ebastler/marbastlib/3dmodels/Diodes_UDFN1212-3_Type-C.step

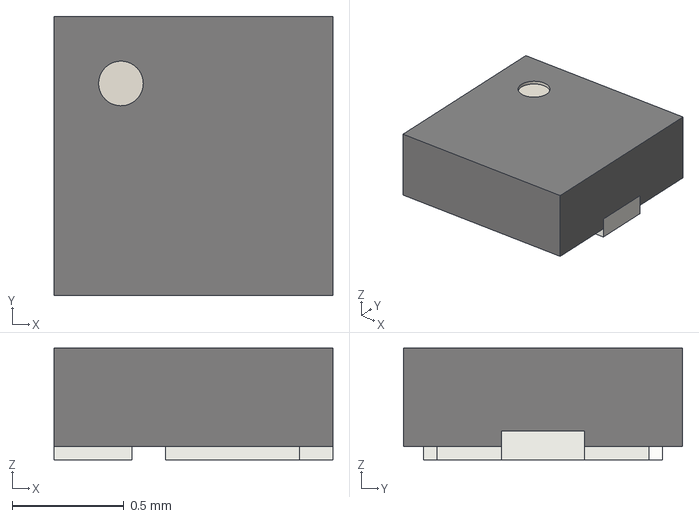
[picture p2: CAD file, 2026-03-22]
3dmodels/Diodes_UDFN1212-3_Type-C.step
1.25 x 1.25 x 0.5 mm
