ebastler/marbastlib/3dmodels/Crystal_SMD_2016-4Pin_2.0x1.6mm.step

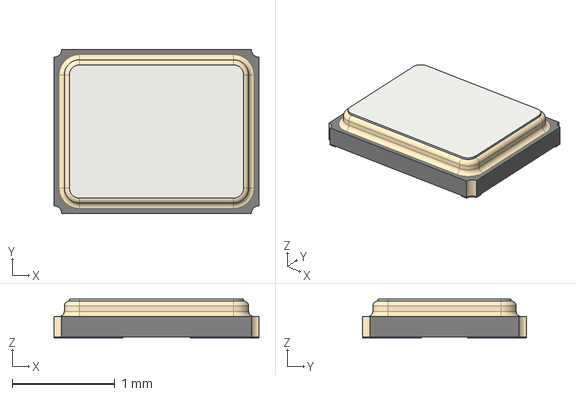
[picture p3: CAD file, 2026-03-22]
3dmodels/Crystal_SMD_2016-4Pin_2.0x1.6mm.step
2.00 x 1.60 x 0.38 mm
