ebastler/marbastlib/3dmodels/SpringContact_SameSky_CPG-45-TH-TR.step

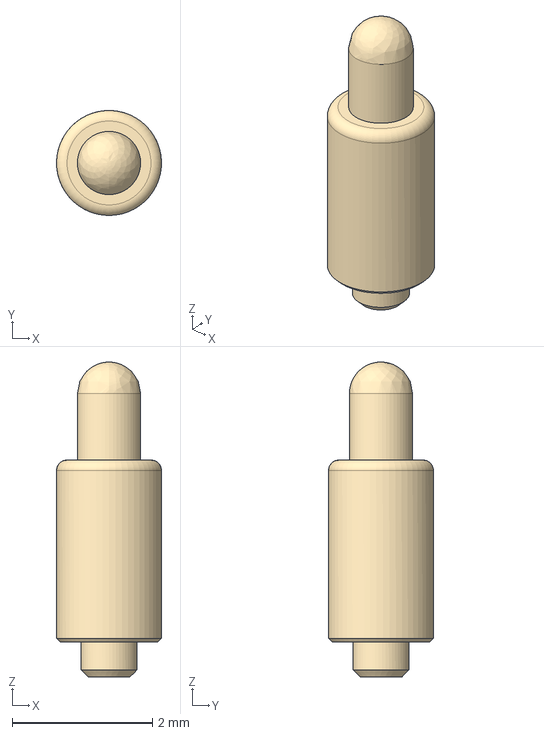
[picture p4: CAD file, 2026-03-22]
3dmodels/SpringContact_SameSky_CPG-45-TH-TR.step
1.50 x 1.50 x 4.50 mm
