ebastler/marbastlib/3dmodels/Mounting_Sinhoo_SolderElement_SMTSO3035CTJ.step

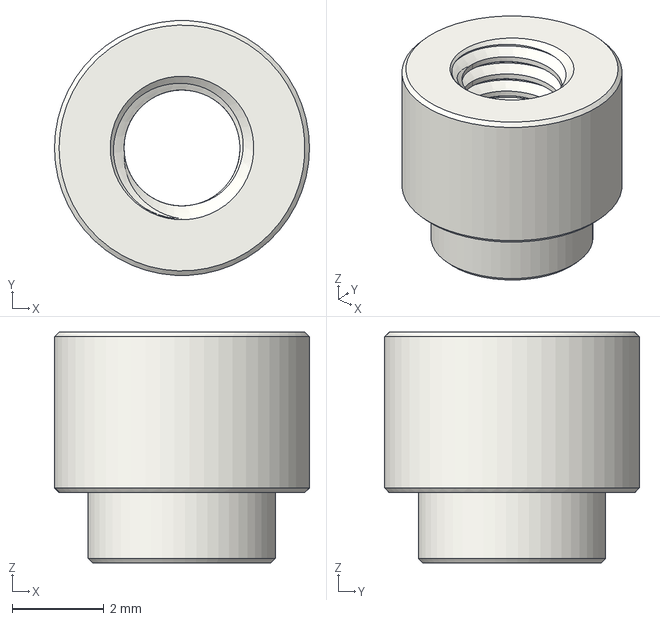
[picture p5: CAD file, 2026-03-22]
3dmodels/Mounting_Sinhoo_SolderElement_SMTSO3035CTJ.step
5.56 x 5.55 x 5.03 mm
