ebastler/marbastlib/3dmodels/LED_Everlight_15-13DR6GHBHC-A012T.step

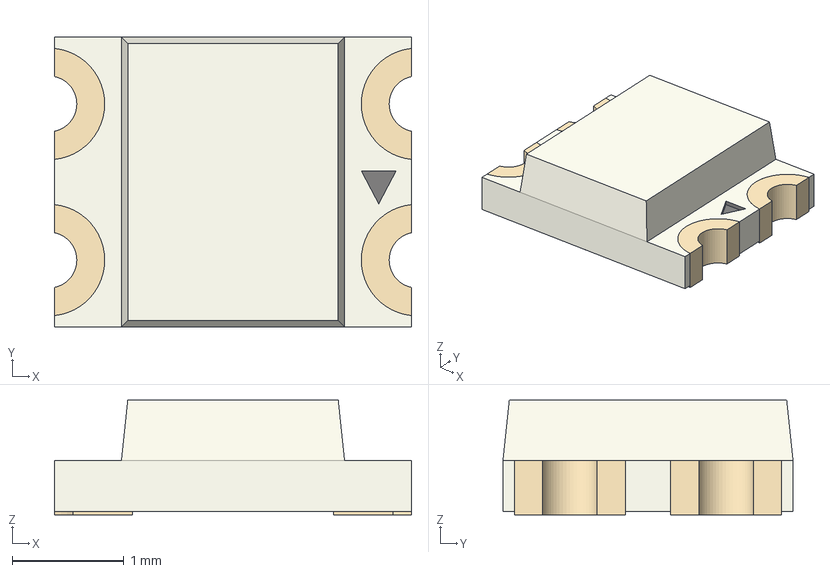
[picture p6: CAD file, 2026-03-22]
3dmodels/LED_Everlight_15-13DR6GHBHC-A012T.step
3.20 x 2.60 x 1.03 mm
