ebastler/marbastlib/3dmodels/SW_Kailh_CPG1316S-2_CAP.step

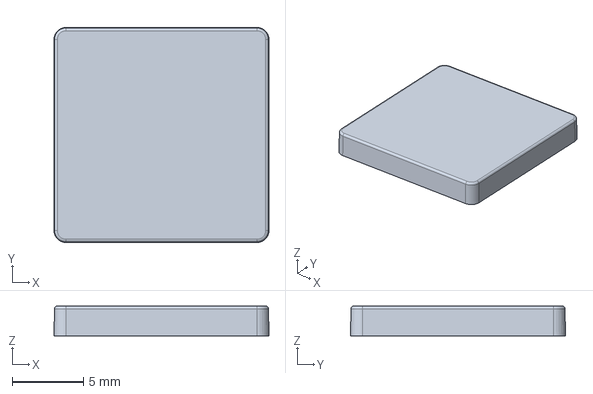
[picture p7: CAD file, 2026-03-22]
3dmodels/SW_Kailh_CPG1316S-2_CAP.step
15.1 x 15.1 x 2.10 mm
