ebastler/marbastlib/3dmodels/Speaker_SELTECH_CR1511L025YN8WP.step

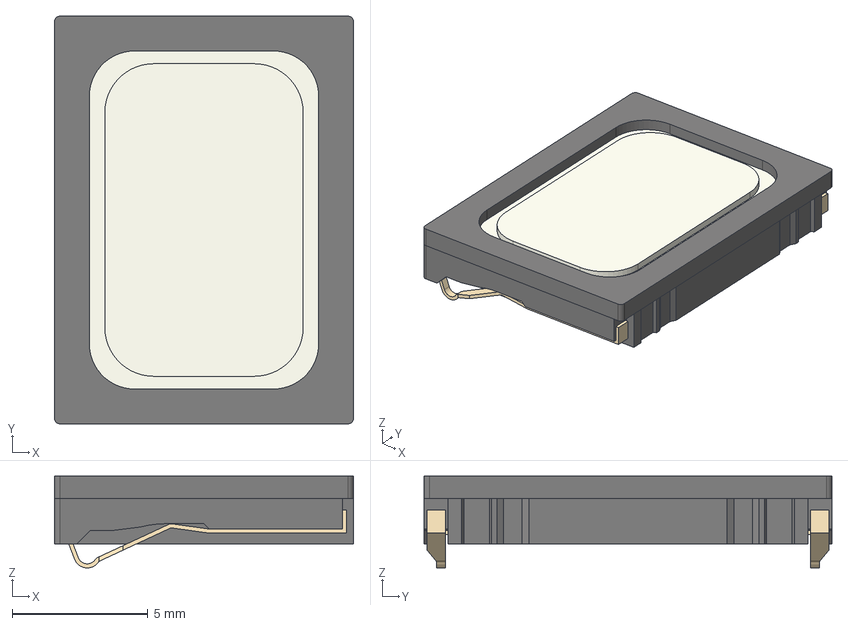
[picture p8: CAD file, 2026-03-22]
3dmodels/Speaker_SELTECH_CR1511L025YN8WP.step
11.0 x 15.0 x 3.38 mm
