ebastler/marbastlib/3dmodels/SW_Kailh_ULP_CPG1316M_CAP.step

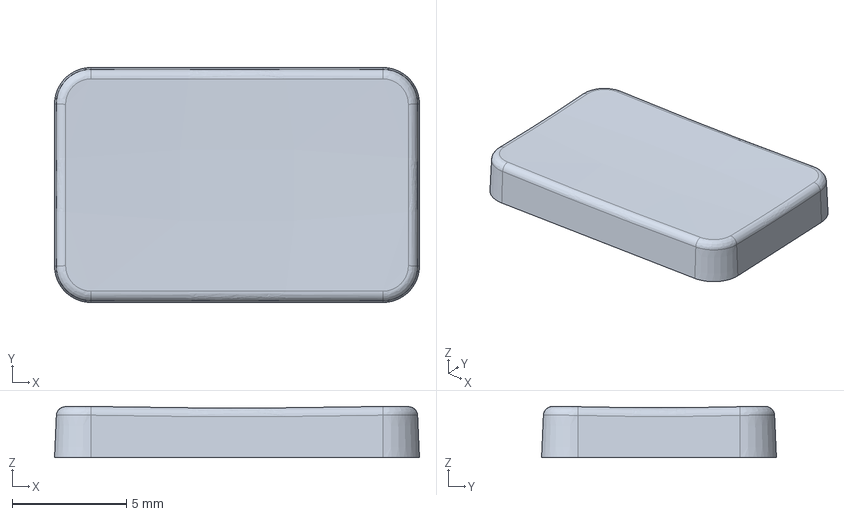
[picture p9: CAD file, 2026-03-22]
3dmodels/SW_Kailh_ULP_CPG1316M_CAP.step
16.0 x 10.3 x 2.25 mm
