ebastler/marbastlib/3dmodels/QFN-14_2x2_Pitch0.4mm.step

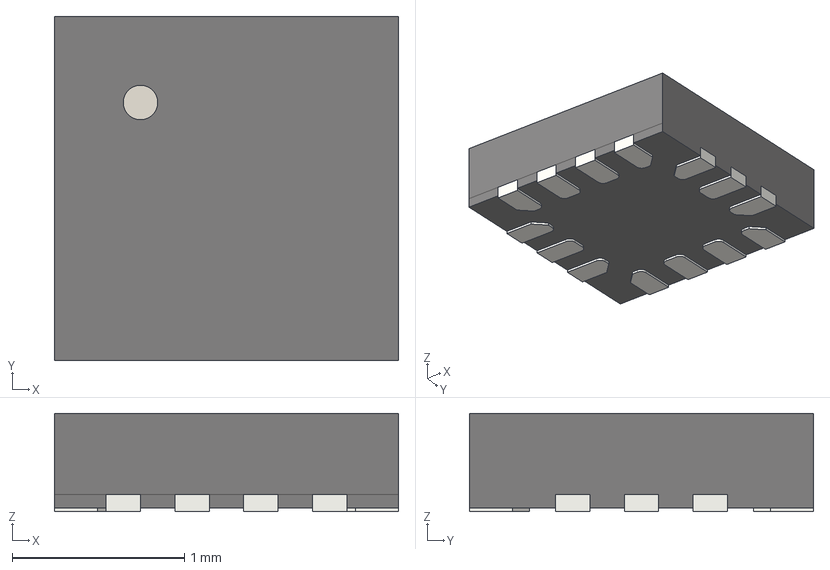
[picture p10: CAD file, 2026-03-22]
3dmodels/QFN-14_2x2_Pitch0.4mm.step
2.00 x 2.00 x 0.57 mm
