ebastler/marbastlib/3dmodels/Texas_OPT3004DNPR_QFN-6_EP_2x2_Pitch0.65mm.step

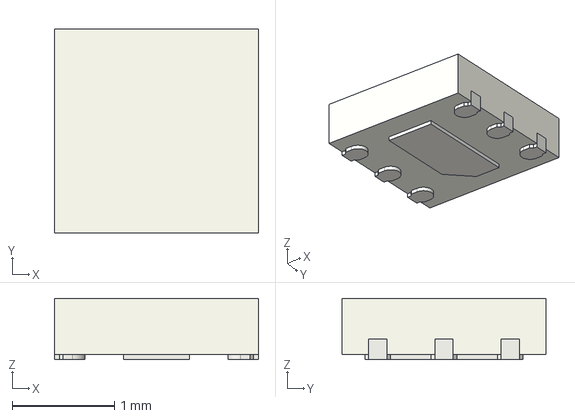
[picture p11: CAD file, 2026-03-22]
3dmodels/Texas_OPT3004DNPR_QFN-6_EP_2x2_Pitch0.65mm.step
2.00 x 2.00 x 0.6 mm
