ebastler/marbastlib/3dmodels/NANOT240BP.step

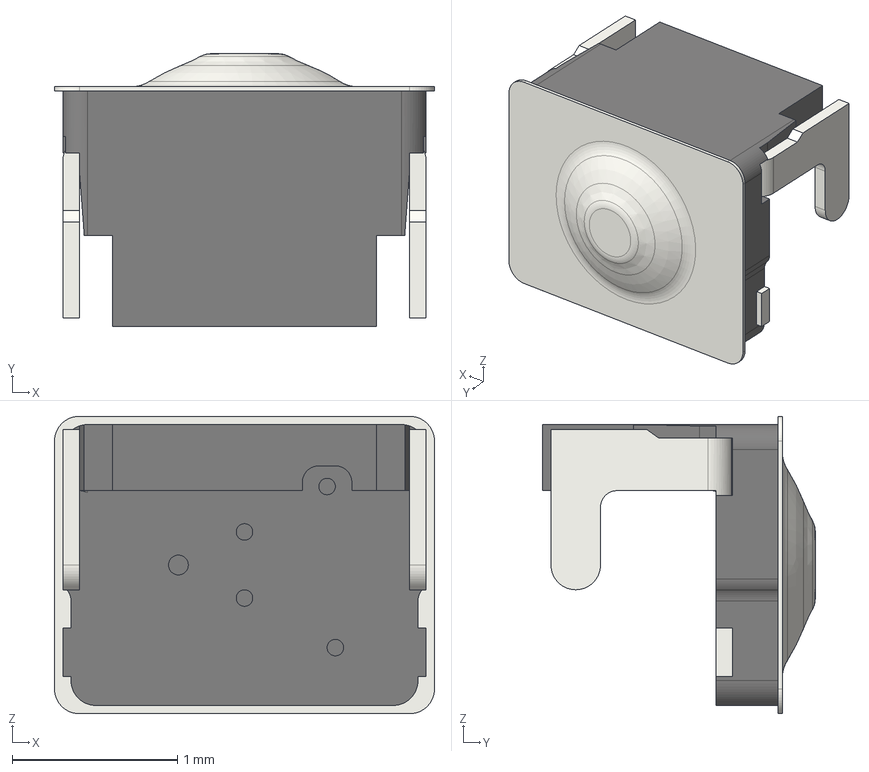
[picture p12: CAD file, 2026-03-22]
3dmodels/NANOT240BP.step
2.30 x 1.65 x 1.80 mm
