ebastler/marbastlib/3dmodels/ANT_Johanson_2450AT18D0100001E v1.step

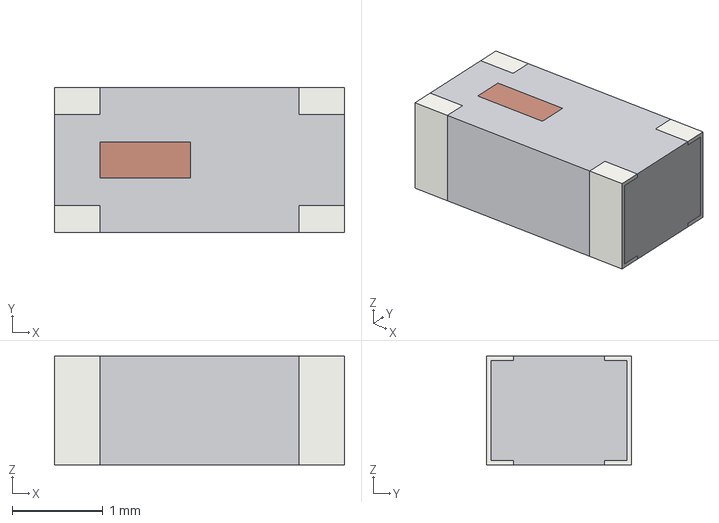
[picture p13: CAD file, 2026-03-22]
3dmodels/ANT_Johanson_2450AT18D0100001E v1.step
3.20 x 1.60 x 1.20 mm
