ebastler/marbastlib/3dmodels/SW_Kailh_CPG1316S-2.step

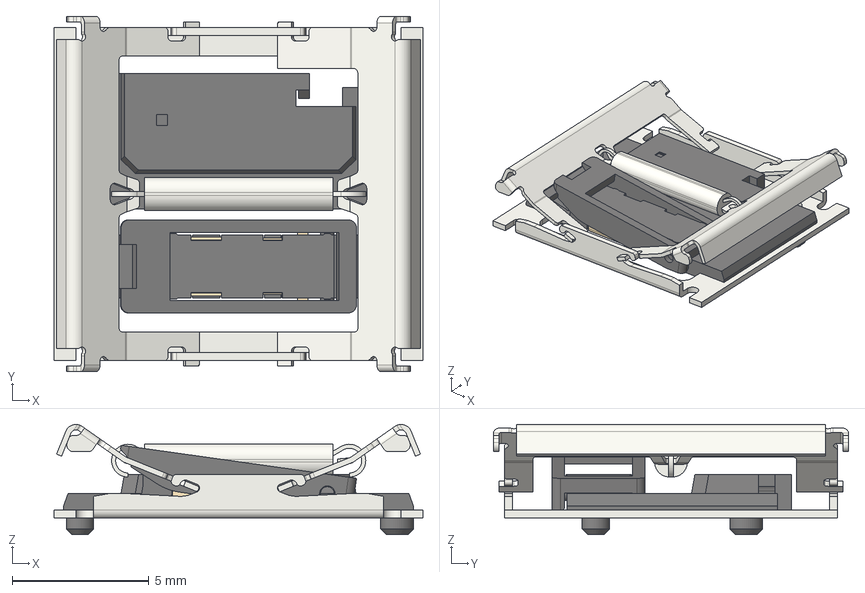
[picture p14: CAD file, 2026-03-22]
3dmodels/SW_Kailh_CPG1316S-2.step
13.5 x 13.0 x 4.03 mm
PG1316S-»ù×ù
Çý¶¯¸Ë
Æ½ºâ¼Ü
À»É
PG1316S-¶¯½Ó´¥Æ¬-´ ø´¥µã
PG1316S-¾²Æ¬-´ø´¥µ ã
Æ½ºâ¼Ü-B
1316S-»ù×ù¿¨¼þ
