ebastler/marbastlib/3dmodels/SpringContact_TE_2329497-2.step

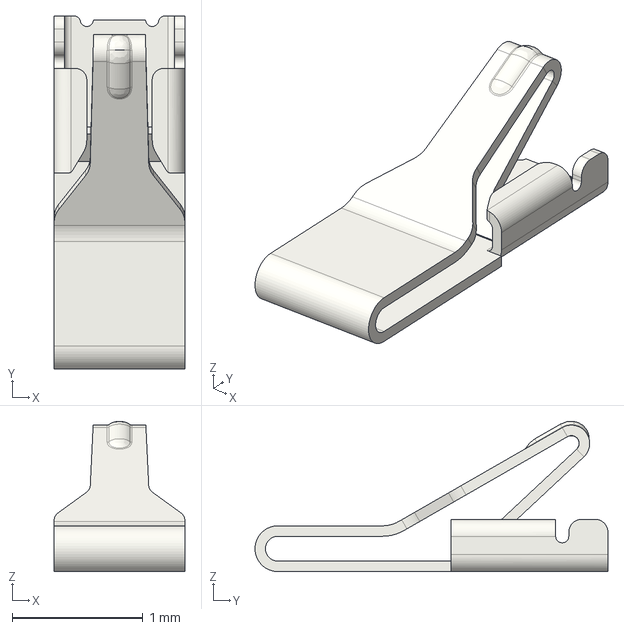
[picture p15: CAD file, 2026-03-22]
3dmodels/SpringContact_TE_2329497-2.step
1.00 x 2.70 x 1.15 mm
