ebastler/marbastlib/3dmodels/Mounting_Wuerth_WA-SMSI-M2_H3P5mm_9774035243R.step

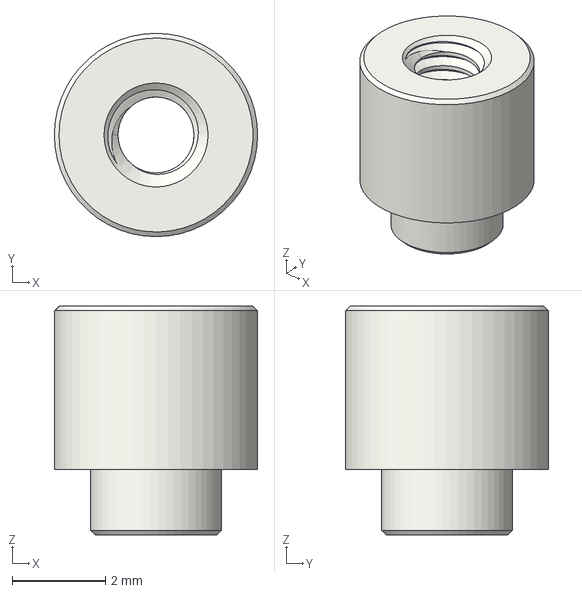
[picture p16: CAD file, 2026-03-22]
3dmodels/Mounting_Wuerth_WA-SMSI-M2_H3P5mm_9774035243R.step
4.35 x 4.35 x 4.90 mm
