ebastler/marbastlib/3dmodels/Crystal_SMD_2012-2Pin_2.0x1.2mm.step

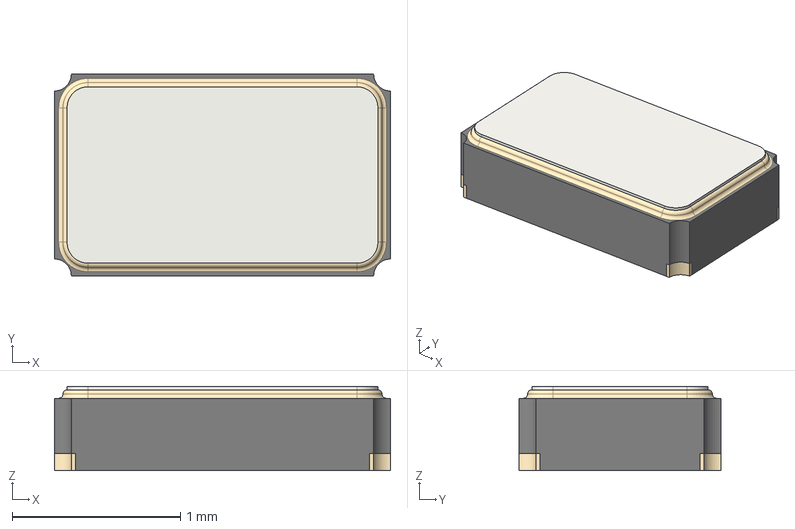
[picture p17: CAD file, 2026-03-22]
3dmodels/Crystal_SMD_2012-2Pin_2.0x1.2mm.step
2.00 x 1.20 x 0.5 mm
