ebastler/marbastlib/3dmodels/Texas_DSBGA-9_1.62x1.58mm_Layout3x3_P0.5mm.step

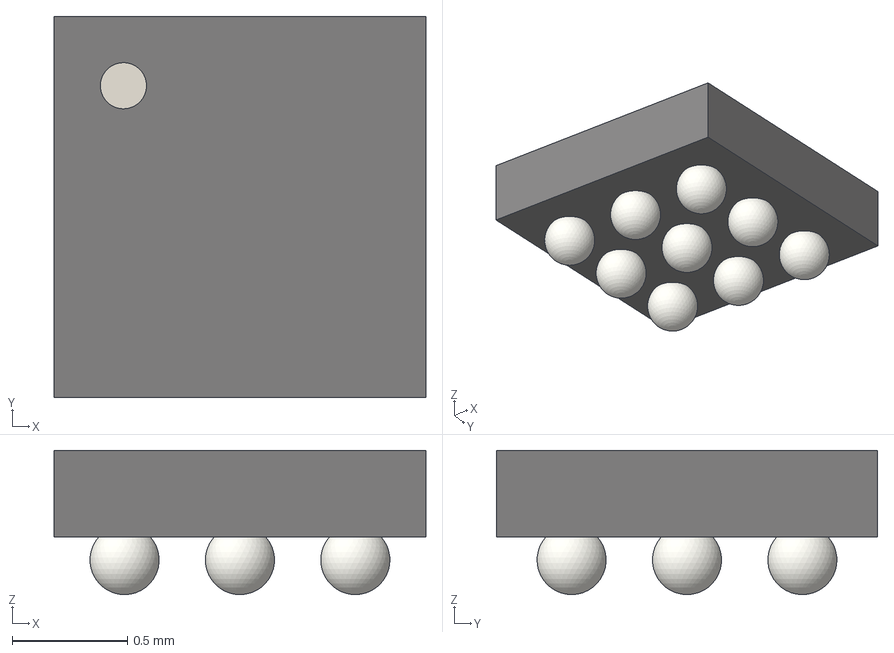
[picture p18: CAD file, 2026-03-22]
3dmodels/Texas_DSBGA-9_1.62x1.58mm_Layout3x3_P0.5mm.step
1.61 x 1.65 x 0.625 mm
