ebastler/marbastlib/3dmodels/Texas_RYK0018A_WQFN-HR-18.step

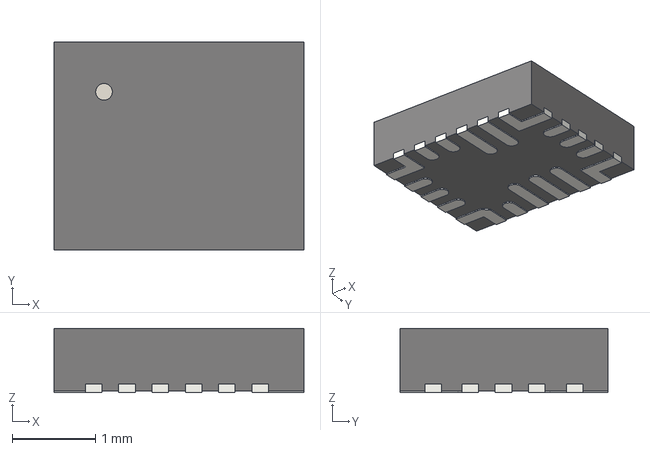
[picture p19: CAD file, 2026-03-22]
3dmodels/Texas_RYK0018A_WQFN-HR-18.step
3.00 x 2.50 x 0.77 mm
