ebastler/marbastlib/3dmodels/USB_C_Receptacle_GCT_USB4505-03-0-A.step

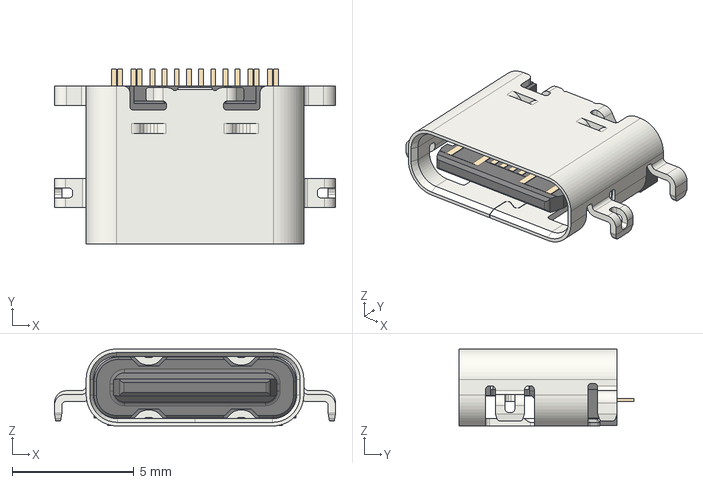
[picture p21: CAD file, 2026-03-22]
3dmodels/USB_C_Receptacle_GCT_USB4505-03-0-A.step
11.5 x 7.20 x 3.16 mm
USB4505-03-0-A_PART1
USB4505-03-0-A_PART2
