ebastler/marbastlib/3dmodels/SW_SPDT_Alps_SSAJ110100.step

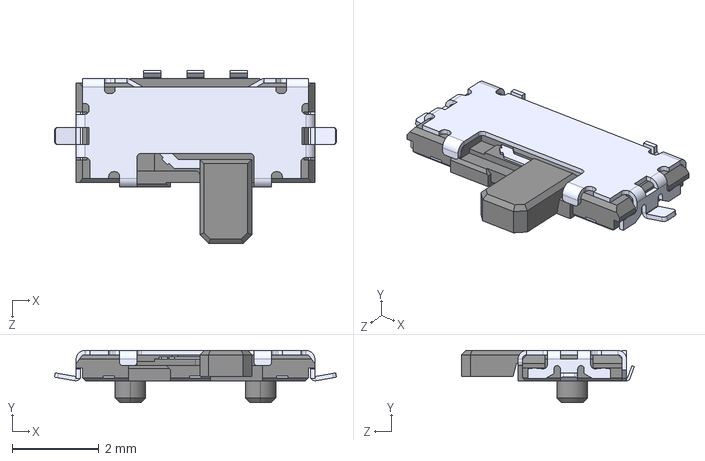
[picture p22: CAD file, 2026-03-22]
3dmodels/SW_SPDT_Alps_SSAJ110100.step
6.50 x 1.20 x 3.98 mm
