ebastler/marbastlib/3dmodels/Texas_X2QFN-12_1.6x1.6mm.step

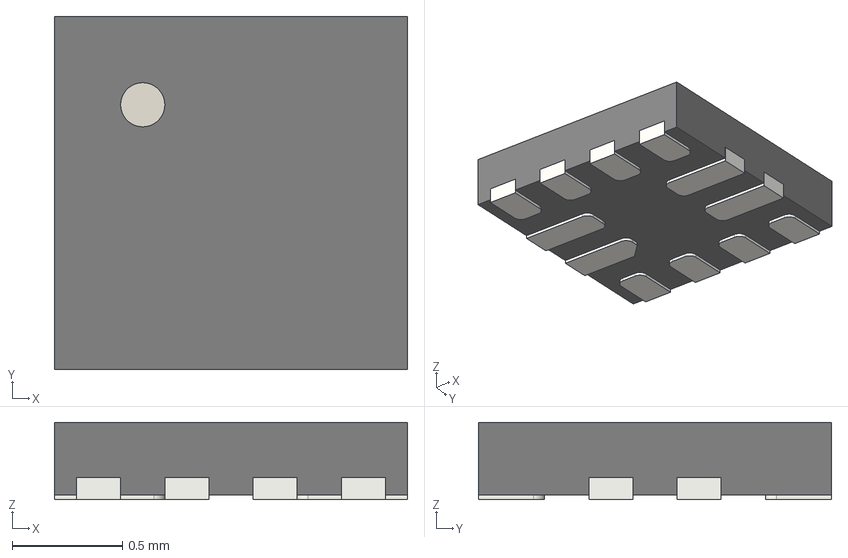
[picture p23: CAD file, 2026-03-22]
3dmodels/Texas_X2QFN-12_1.6x1.6mm.step
1.60 x 1.60 x 0.35 mm
