ebastler/marbastlib/3dmodels/USB_C_Receptacle_GCT_USB4510-03-1-A.step

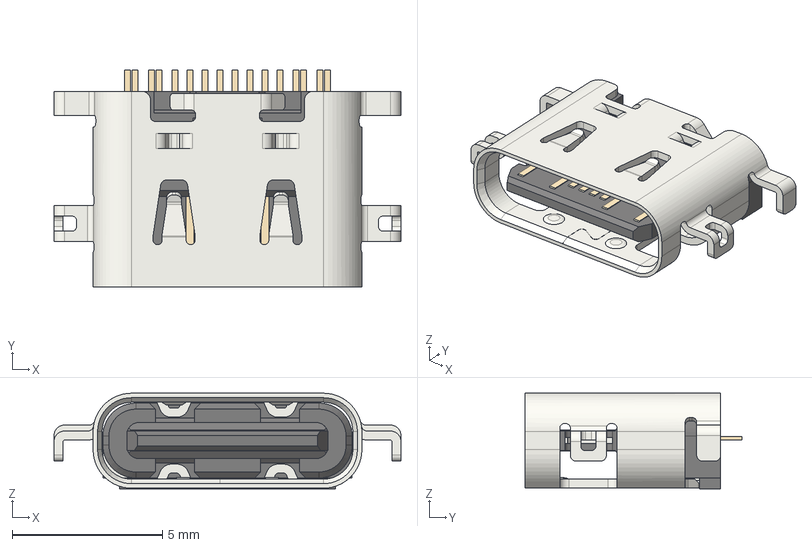
[picture p24: CAD file, 2026-03-22]
3dmodels/USB_C_Receptacle_GCT_USB4510-03-1-A.step
11.5 x 7.20 x 3.18 mm
