ebastler/marbastlib/3dmodels/Mounting_Wuerth_WA-SMSI-M2.5_H1mm_9774010151R.step

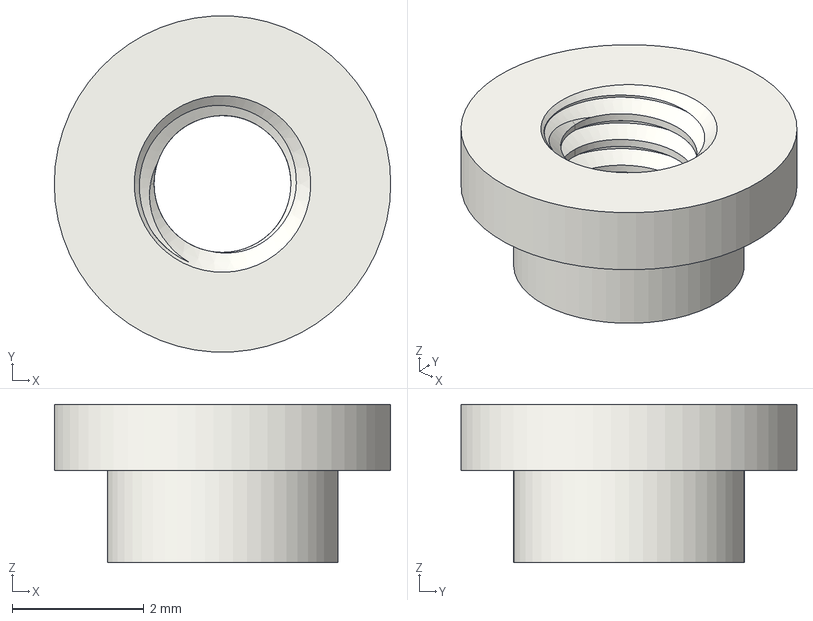
[picture p25: CAD file, 2026-03-22]
3dmodels/Mounting_Wuerth_WA-SMSI-M2.5_H1mm_9774010151R.step
5.10 x 5.09 x 2.40 mm
