ebastler/marbastlib/3dmodels/RP2040-Matrix.step

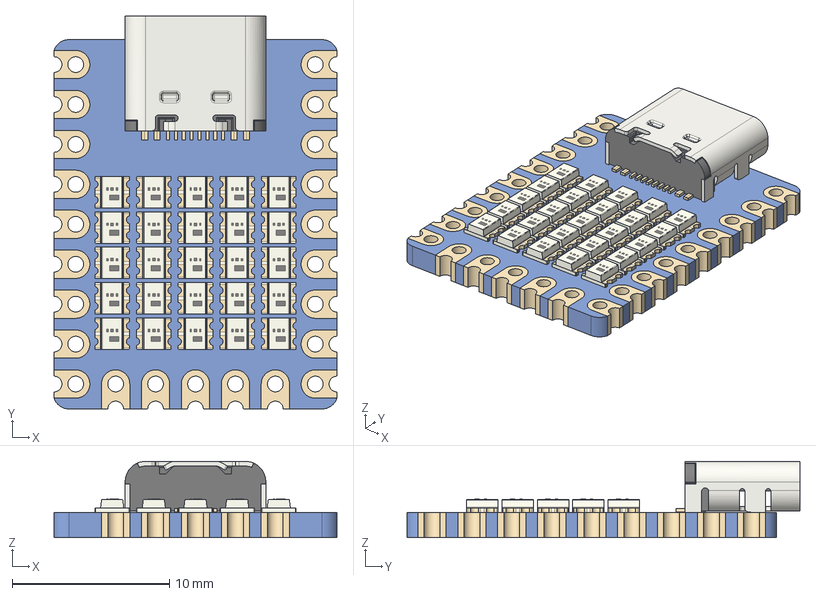
[picture p26: CAD file, 2024-08-18]
3dmodels/RP2040-Matrix.step
18.0 x 25.0 x 4.85 mm
LED_WS2812_2020 x 25
ConPins
PcbPins
Mold
Frame
