ebastler/marbastlib/3dmodels/CON_2121340004.step

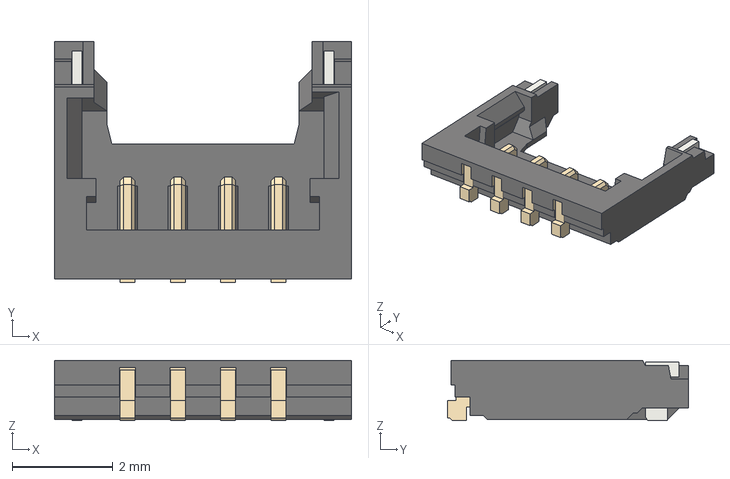
[picture p27: CAD file, 2024-07-13]
3dmodels/CON_2121340004.step
5.90 x 4.79 x 1.20 mm
