ebastler/marbastlib/3dmodels/CON_TYPE-C-31-M-23.step

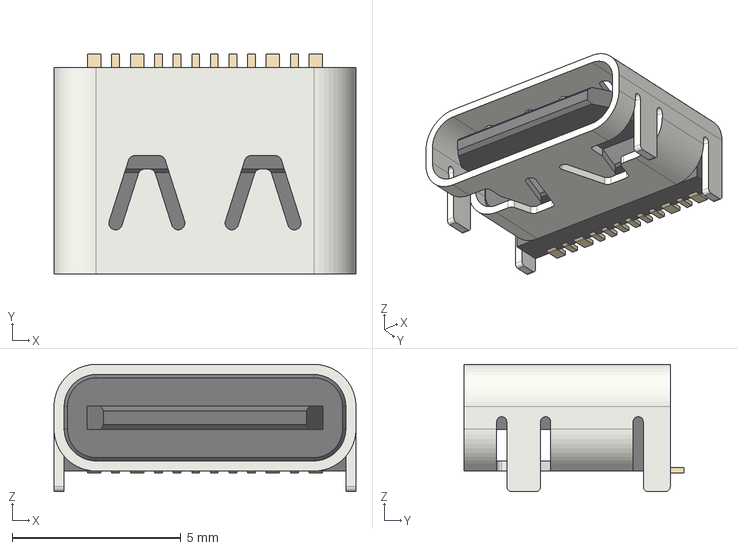
[picture p28: CAD file, 2024-07-13]
3dmodels/CON_TYPE-C-31-M-23.step
8.94 x 6.50 x 3.77 mm
