ebastler/marbastlib/3dmodels/LED_SK6812MINI-E.step

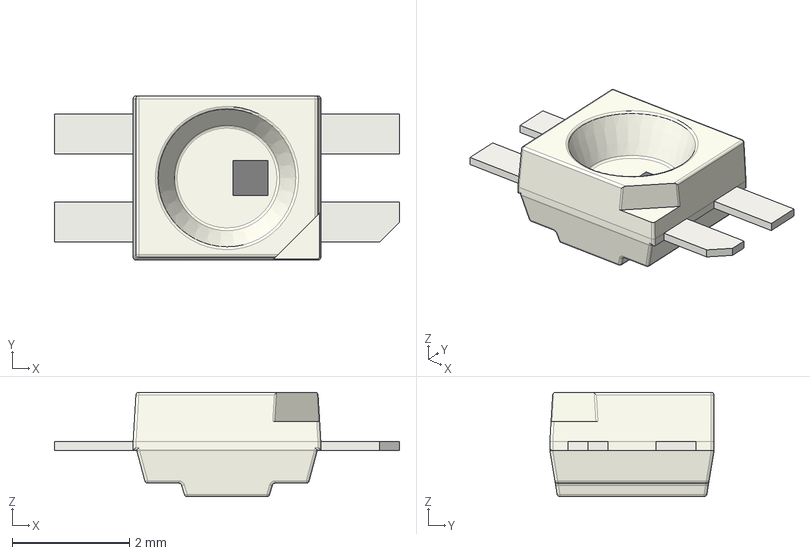
[picture p29: CAD file, 2024-07-13]
3dmodels/LED_SK6812MINI-E.step
5.88 x 2.80 x 1.78 mm
