ebastler/marbastlib/3dmodels/CON_XUNPU_FPC-0.5AL-20PB.step

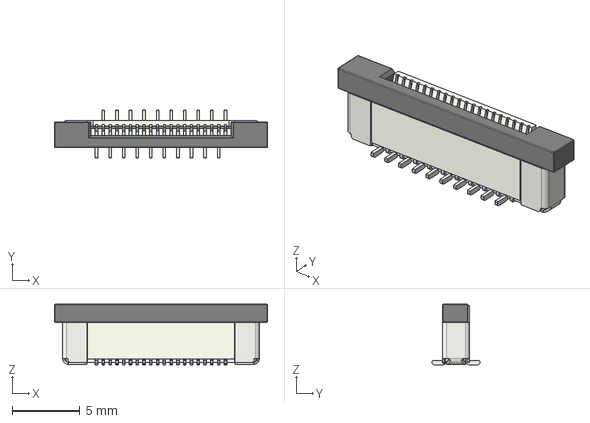
[picture p30: CAD file, 2024-07-13]
3dmodels/CON_XUNPU_FPC-0.5AL-20PB.step
15.7 x 3.52 x 4.47 mm
