ebastler/marbastlib/3dmodels/moko_mk08a_nRF52840.step

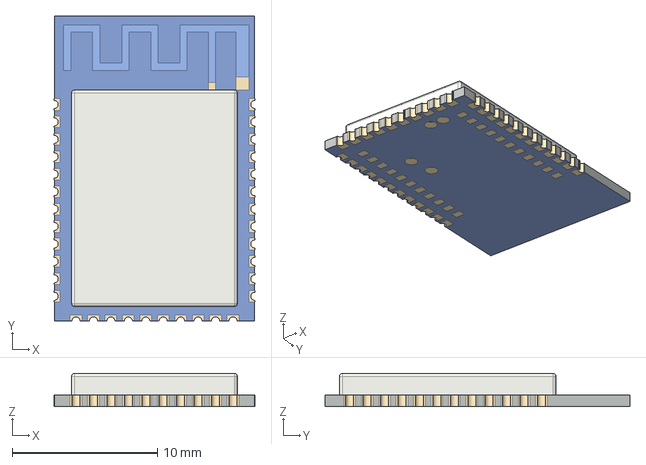
[picture p31: CAD file, 2024-07-13]
3dmodels/moko_mk08a_nRF52840.step
13.8 x 21.0 x 2.29 mm
