ebastler/marbastlib/3dmodels/HS_CPG151101S11_MX.step

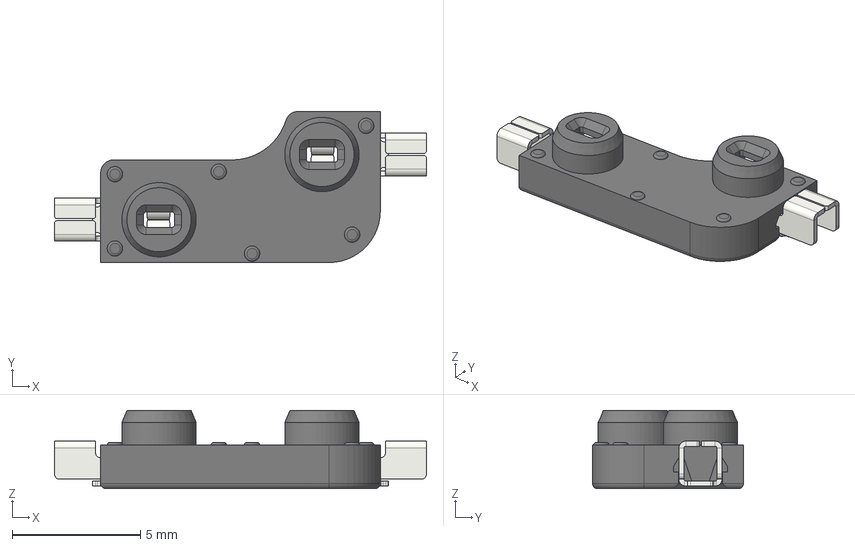
[picture p32: CAD file, 2024-07-13]
3dmodels/HS_CPG151101S11_MX.step
14.5 x 5.89 x 3.05 mm
Contact x 2
