ebastler/marbastlib/3dmodels/CON_SM05B-SRSS-TB.step

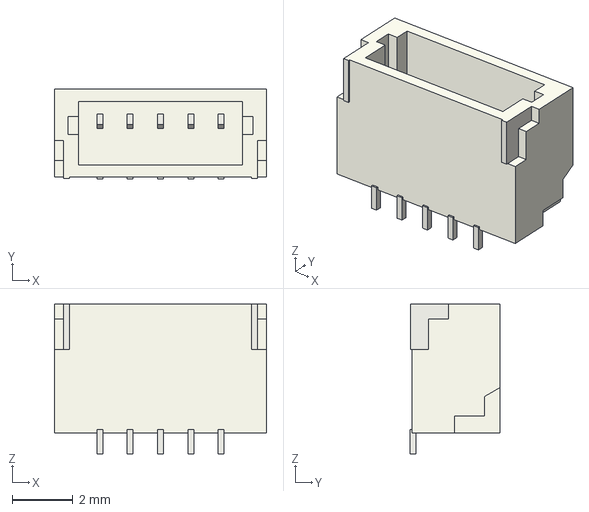
[picture p33: CAD file, 2024-07-13]
3dmodels/CON_SM05B-SRSS-TB.step
7.00 x 2.96 x 4.95 mm
