ebastler/marbastlib/3dmodels/PDFN3.3x3.3.step

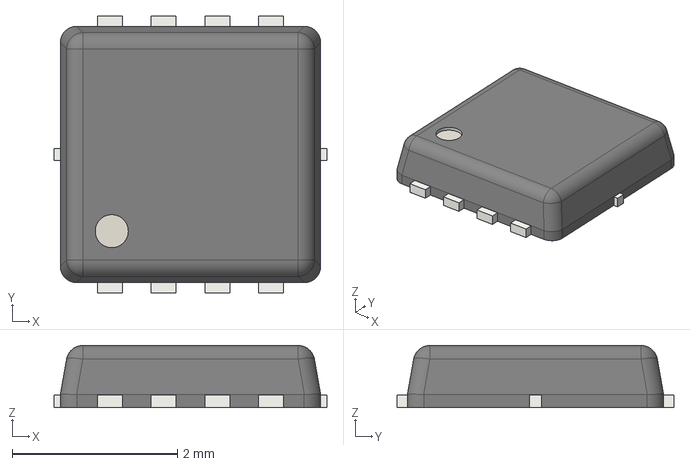
[picture p34: CAD file, 2024-07-13]
3dmodels/PDFN3.3x3.3.step
3.30 x 3.35 x 0.75 mm
