ebastler/marbastlib/3dmodels/SW_T1A2QR.step

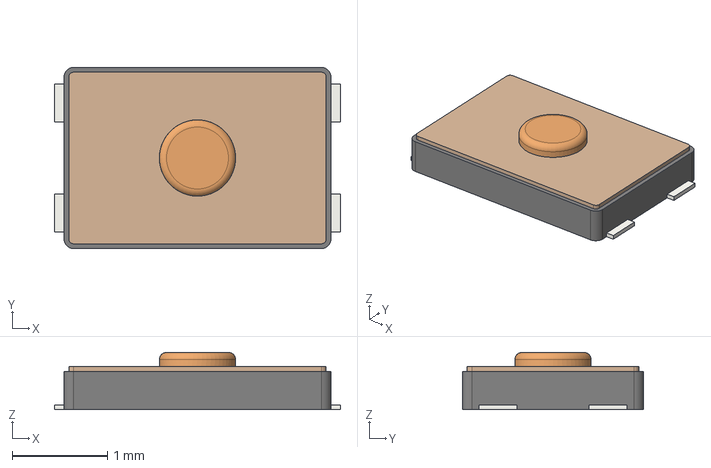
[picture p35: CAD file, 2024-07-13]
3dmodels/SW_T1A2QR.step
3.00 x 1.90 x 0.6 mm
