ebastler/marbastlib/3dmodels/CON_2082940030.step

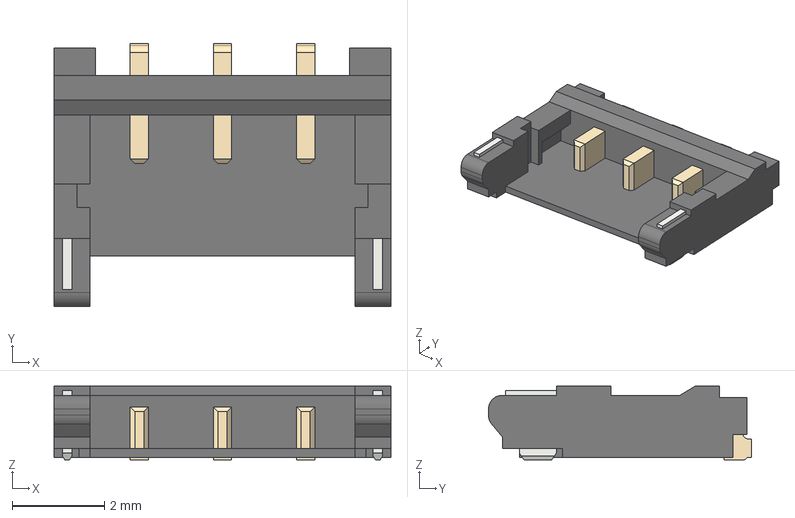
[picture p36: CAD file, 2024-07-13]
3dmodels/CON_2082940030.step
7.30 x 5.70 x 1.60 mm
