ebastler/marbastlib/3dmodels/Liatris.step

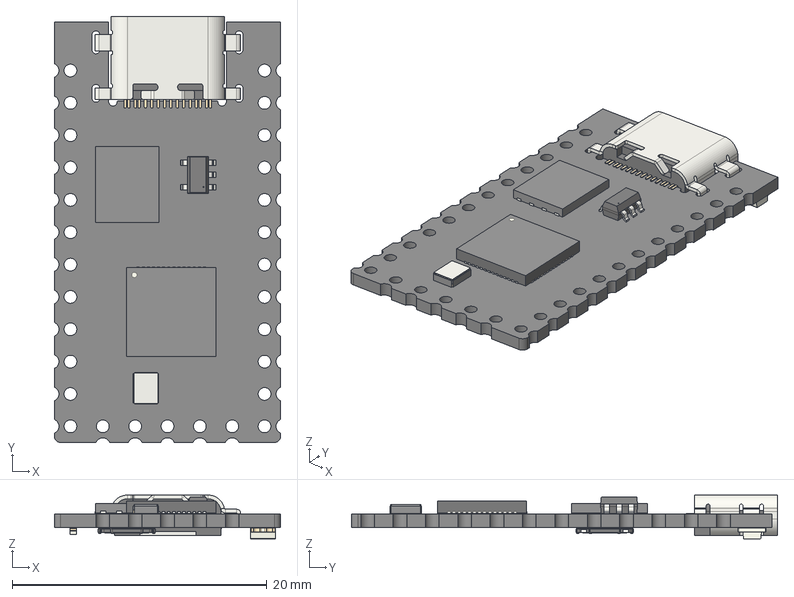
[picture p37: CAD file, 2024-07-13]
3dmodels/Liatris.step
17.8 x 33.5 x 3.44 mm
RP2040 PCB
