ebastler/marbastlib/3dmodels/HS_KS-2P02B01-02_KS33.step

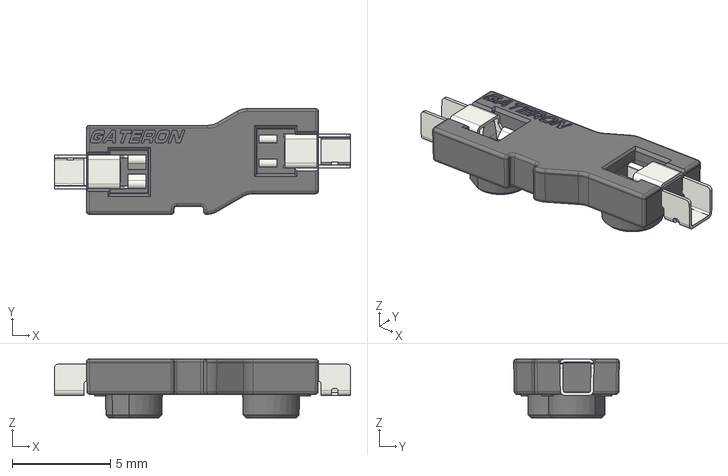
[picture p38: CAD file, 2024-07-13]
3dmodels/HS_KS-2P02B01-02_KS33.step
15.1 x 5.39 x 3.00 mm
