ebastler/marbastlib/3dmodels/SW_MSK12C02.step

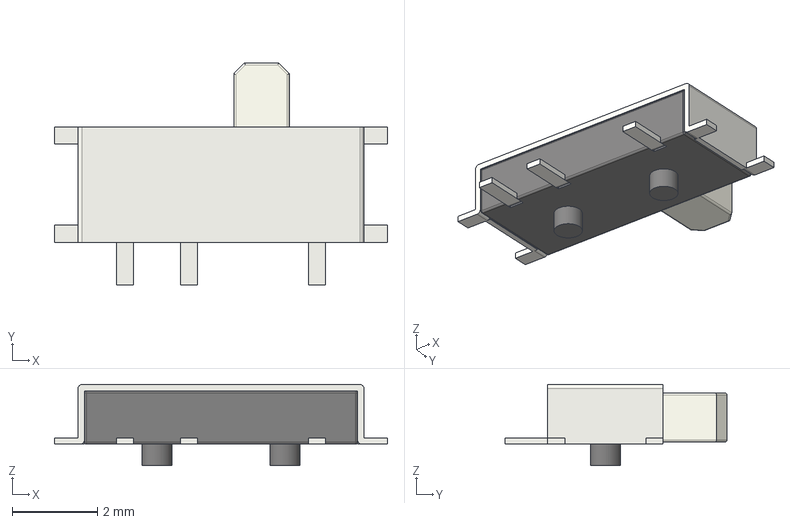
[picture p39: CAD file, 2024-07-13]
3dmodels/SW_MSK12C02.step
7.80 x 5.20 x 1.90 mm
