ebastler/marbastlib/3dmodels/L_Bourns_SRP6050CA.step

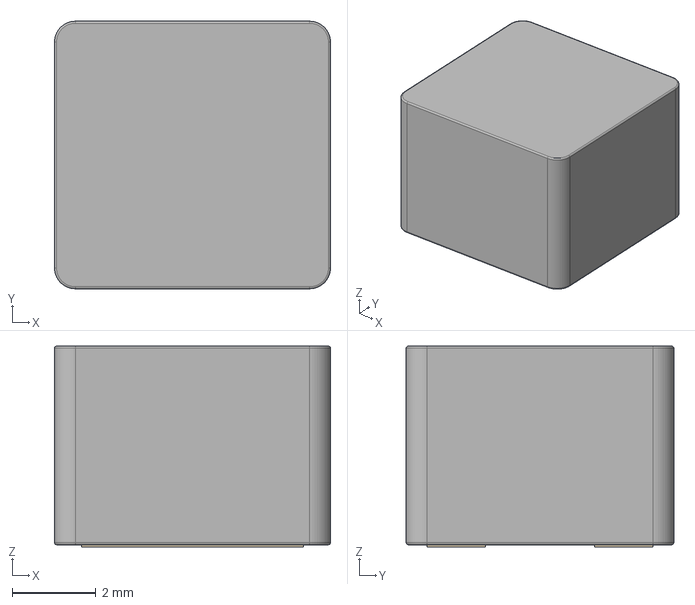
[picture p40: CAD file, 2024-07-13]
3dmodels/L_Bourns_SRP6050CA.step
6.60 x 6.40 x 4.80 mm
