ebastler/marbastlib/3dmodels/L_Cenker_CKST353220.step

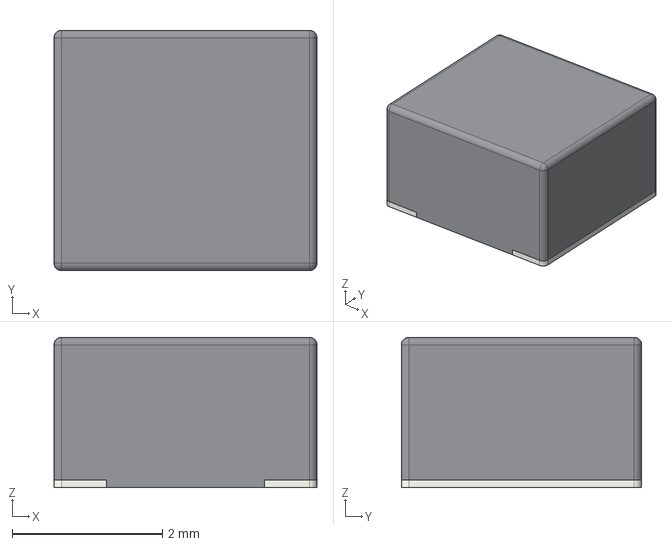
[picture p41: CAD file, 2024-07-13]
3dmodels/L_Cenker_CKST353220.step
3.50 x 3.20 x 2.00 mm
