ebastler/marbastlib/3dmodels/L_Bourns_SRP6060FA.step

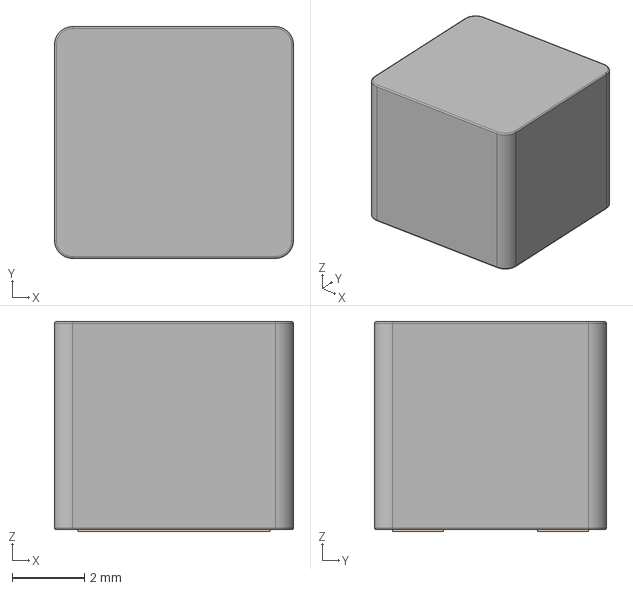
[picture p42: CAD file, 2024-07-13]
3dmodels/L_Bourns_SRP6060FA.step
6.60 x 6.40 x 5.80 mm
