ebastler/marbastlib/3dmodels/CON_MJ-4PP-9.step

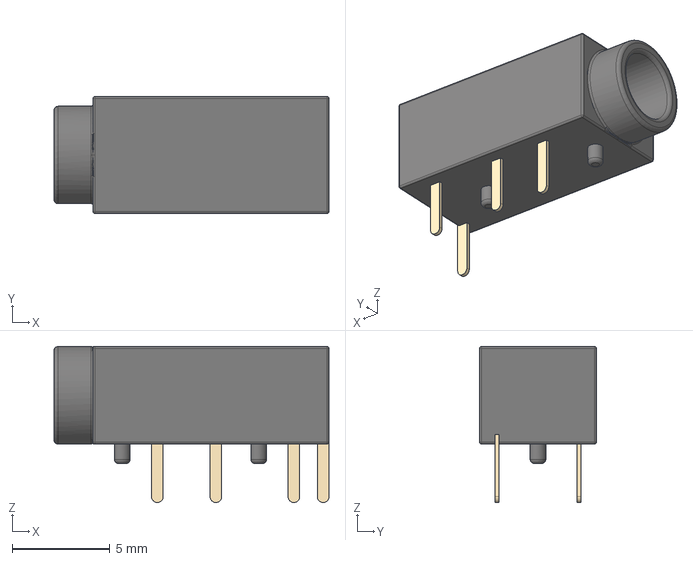
[picture p44: CAD file, 2024-07-13]
3dmodels/CON_MJ-4PP-9.step
14.1 x 6.00 x 8.00 mm
