ebastler/marbastlib/3dmodels/CON_2121340002.step

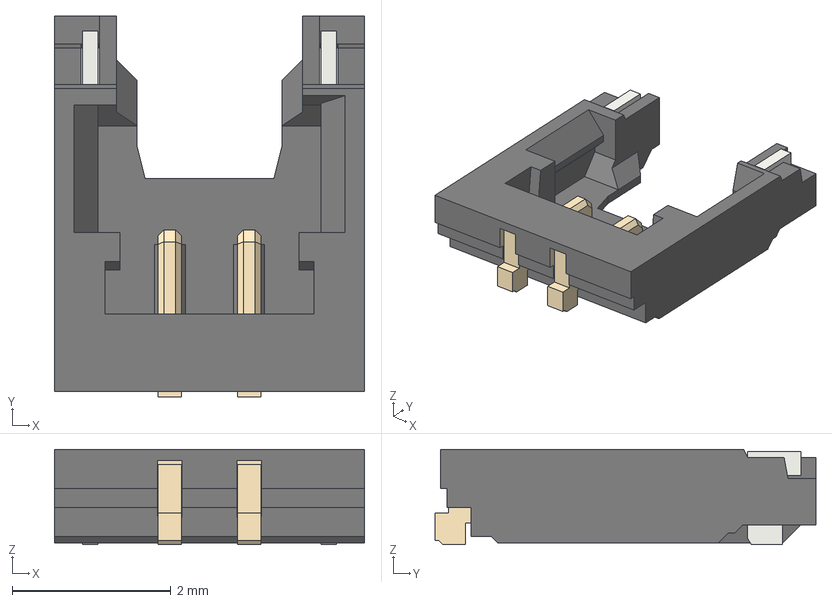
[picture p45: CAD file, 2024-07-13]
3dmodels/CON_2121340002.step
3.90 x 4.79 x 1.20 mm
