ebastler/marbastlib/3dmodels/CON_SM04B-SRSS-TB.step

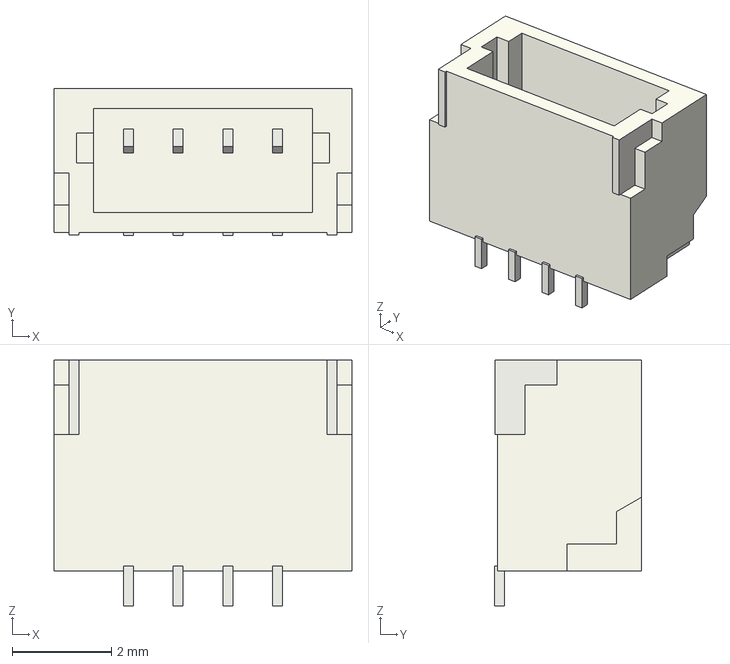
[picture p46: CAD file, 2024-07-13]
3dmodels/CON_SM04B-SRSS-TB.step
6.00 x 2.96 x 4.95 mm
