ebastler/marbastlib/3dmodels/CON_2082940040.step

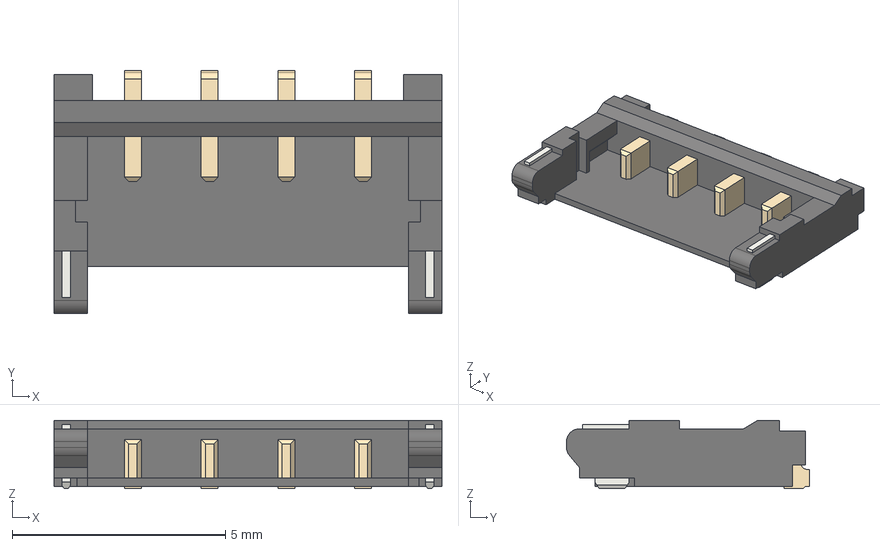
[picture p47: CAD file, 2024-07-13]
3dmodels/CON_2082940040.step
9.10 x 5.70 x 1.60 mm
