ebastler/marbastlib/3dmodels/CON_781715006.step

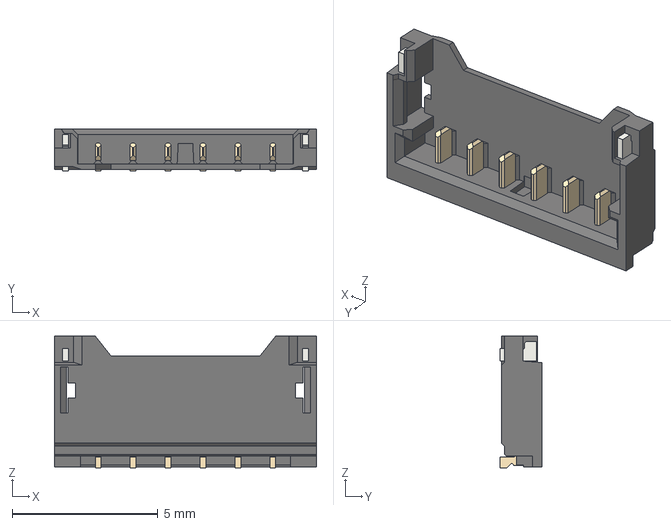
[picture p48: CAD file, 2024-07-13]
3dmodels/CON_781715006.step
9.00 x 1.45 x 4.53 mm
