ebastler/marbastlib/3dmodels/CON_XUNPU_FPC-05F-24PH20.step

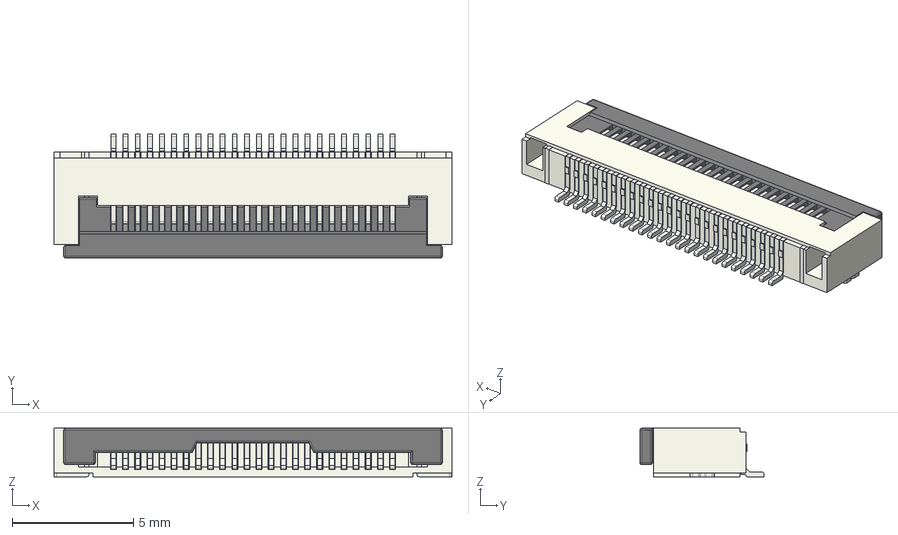
[picture p49: CAD file, 2024-07-13]
3dmodels/CON_XUNPU_FPC-05F-24PH20.step
16.4 x 5.12 x 2.00 mm
Board
