ebastler/marbastlib/3dmodels/LED_WS2812B-MINI.step

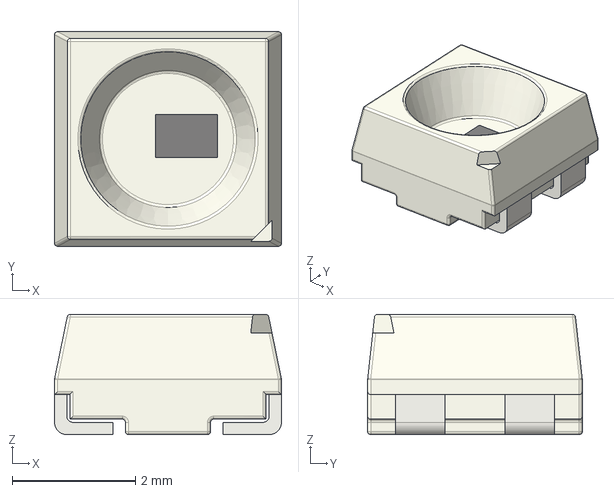
[picture p50: CAD file, 2024-07-13]
3dmodels/LED_WS2812B-MINI.step
3.68 x 3.48 x 1.95 mm
