ebastler/marbastlib/3dmodels/SW_SSSS223900.step

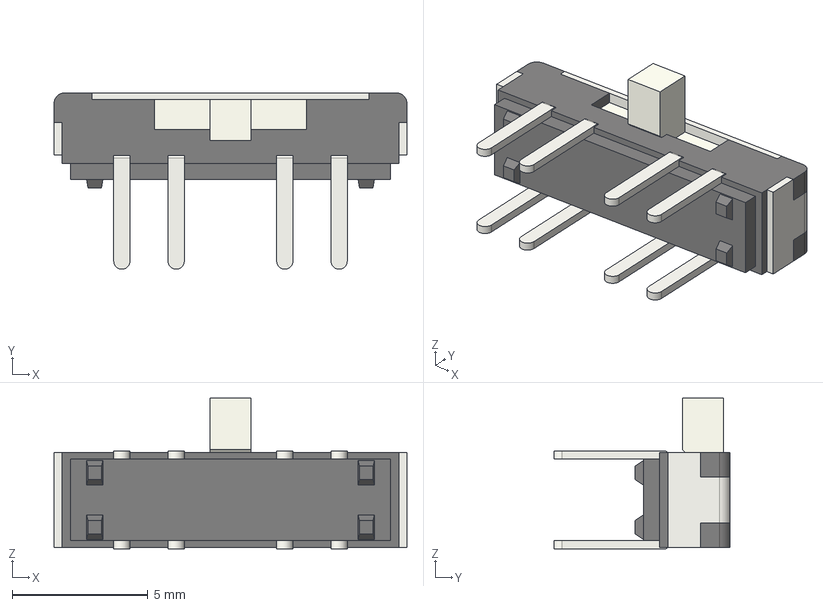
[picture p51: CAD file, 2024-07-13]
3dmodels/SW_SSSS223900.step
13.0 x 6.50 x 5.55 mm
