ebastler/marbastlib/3dmodels/HS_CPG135001S30_Choc.step

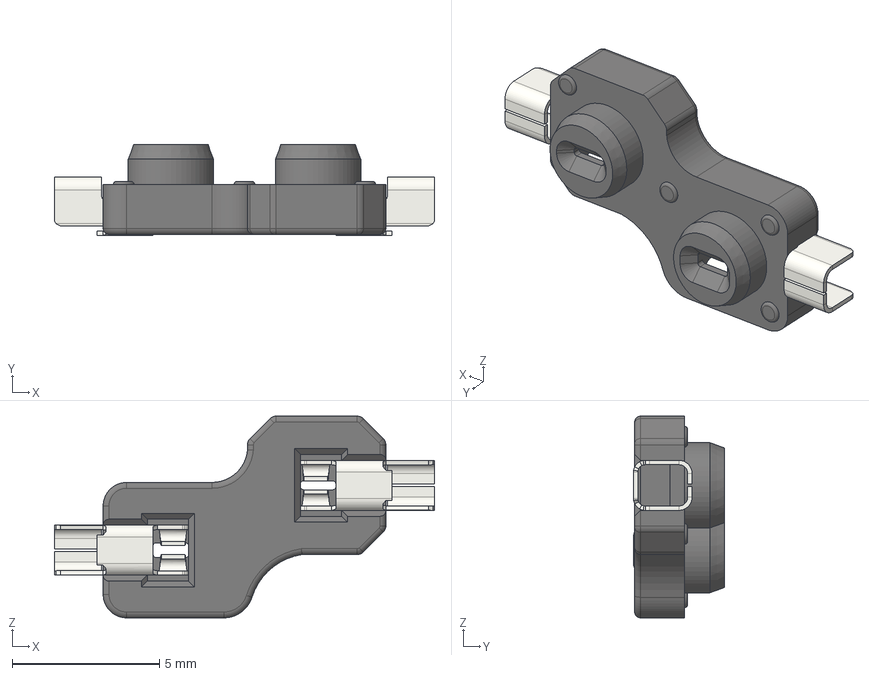
[picture p52: CAD file, 2024-07-13]
3dmodels/HS_CPG135001S30_Choc.step
12.9 x 3.09 x 6.85 mm
pin x 2
socket
