ebastler/marbastlib/3dmodels/CON_2121340006.step

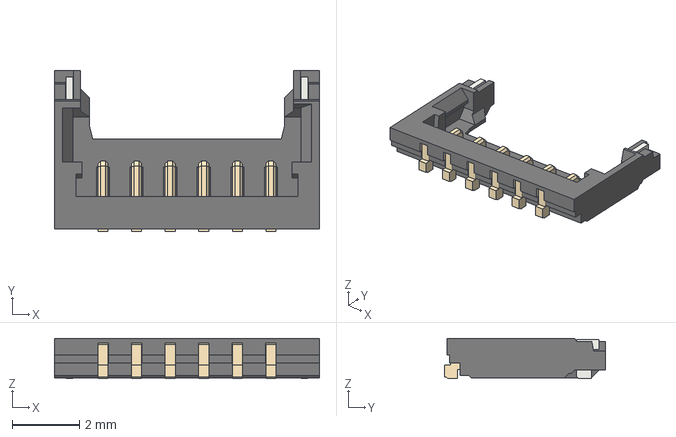
[picture p53: CAD file, 2024-07-13]
3dmodels/CON_2121340006.step
7.90 x 4.79 x 1.20 mm
