ebastler/marbastlib/3dmodels/holyiot_18010_nRF52840.step

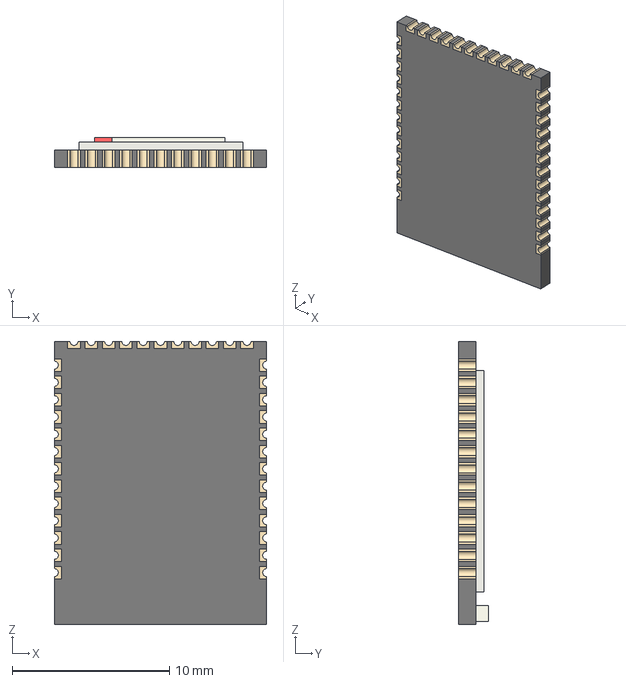
[picture p54: CAD file, 2024-07-13]
3dmodels/holyiot_18010_nRF52840.step
13.5 x 1.92 x 18.0 mm
