ebastler/marbastlib/3dmodels/CON_SM08B-SRSS-TB.step

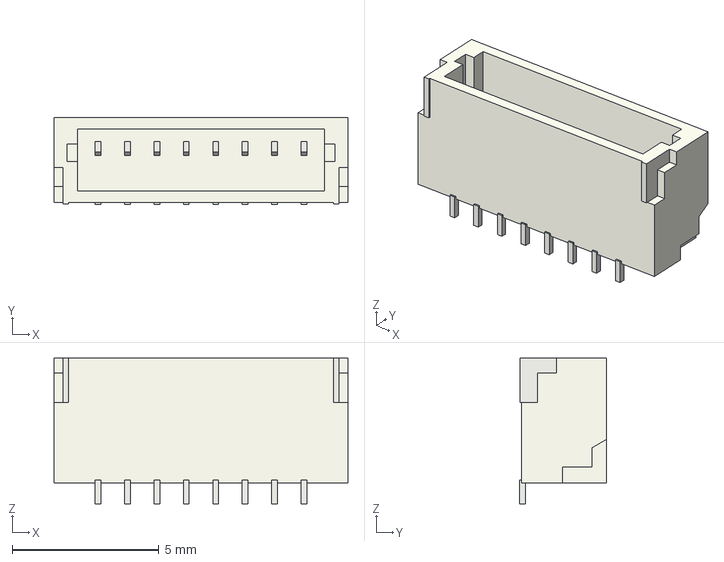
[picture p55: CAD file, 2024-07-13]
3dmodels/CON_SM08B-SRSS-TB.step
10.0 x 2.96 x 4.95 mm
