ebastler/marbastlib/3dmodels/CON_SM13B-SRSS-TB.step

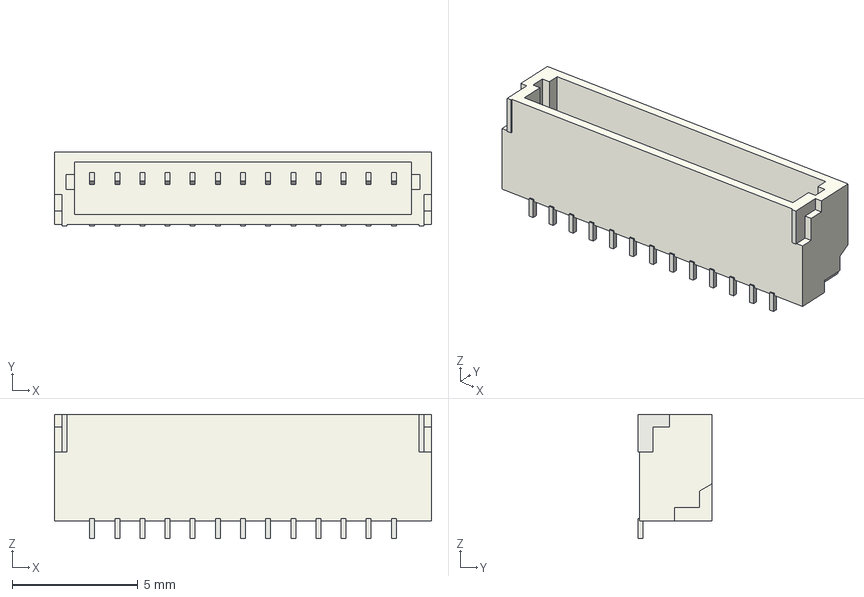
[picture p56: CAD file, 2024-07-13]
3dmodels/CON_SM13B-SRSS-TB.step
15.0 x 2.96 x 4.95 mm
