ebastler/marbastlib/3dmodels/CON_XUNPU_FPC-05F-20PH20.step

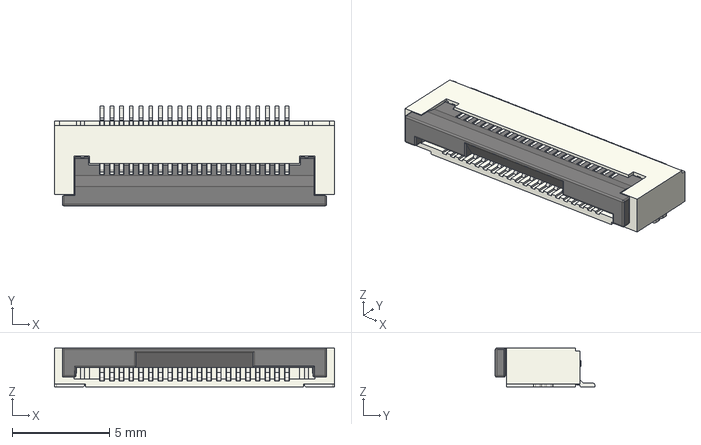
[picture p57: CAD file, 2024-07-13]
3dmodels/CON_XUNPU_FPC-05F-20PH20.step
14.4 x 5.12 x 2.00 mm
Board
