ebastler/marbastlib/3dmodels/CON_BM02B-ACHSS.step

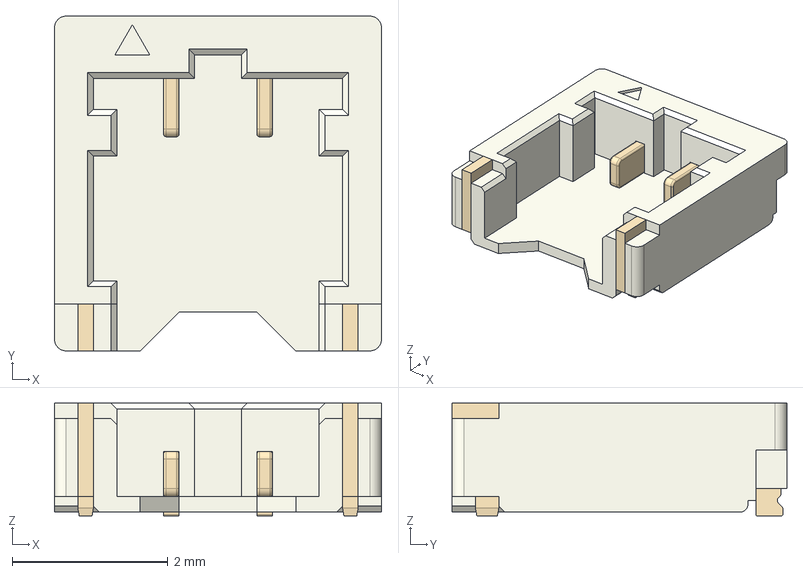
[picture p58: CAD file, 2024-07-13]
3dmodels/CON_BM02B-ACHSS.step
4.20 x 4.30 x 1.45 mm
