ebastler/marbastlib/3dmodels/CON_XUNPU_FPC-05F-16PH20.step

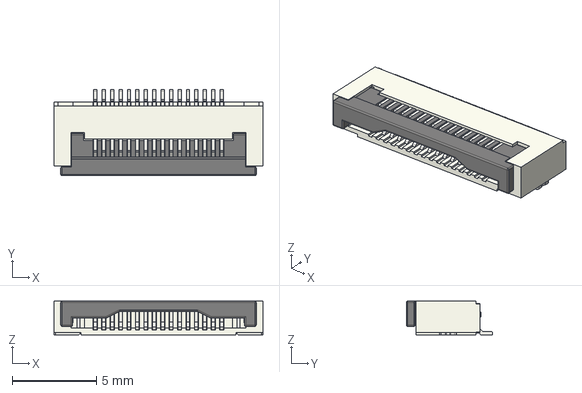
[picture p59: CAD file, 2024-07-13]
3dmodels/CON_XUNPU_FPC-05F-16PH20.step
12.4 x 5.12 x 2.00 mm
