ebastler/marbastlib/3dmodels/ebyte_E73-2G4M08S1C.step

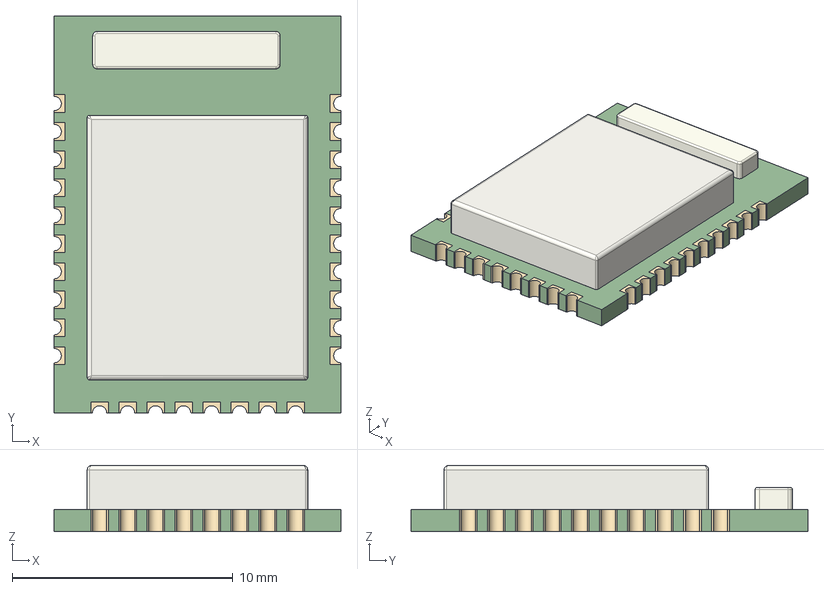
[picture p60: CAD file, 2024-07-13]
3dmodels/ebyte_E73-2G4M08S1C.step
13.0 x 18.0 x 3.00 mm
