ebastler/marbastlib/3dmodels/CON_HytePro_M411P_Receptacle_1x04.step

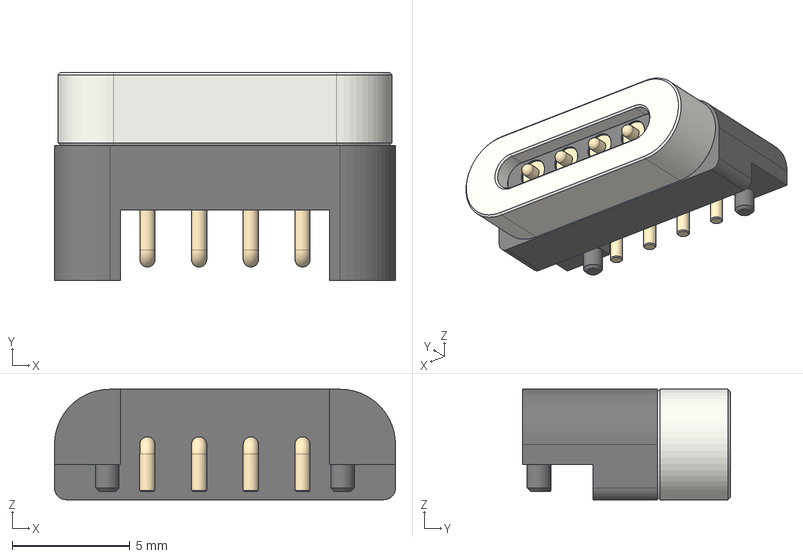
[picture p61: CAD file, 2024-07-13]
3dmodels/CON_HytePro_M411P_Receptacle_1x04.step
14.5 x 8.85 x 4.70 mm
Magnetic Connector Female - MiddlePart
Magnetic Connector Female-tip_Standard
Magnetic Connector Female v2 - MountingPart
