ebastler/marbastlib/3dmodels/LED_WS2812_2020.step

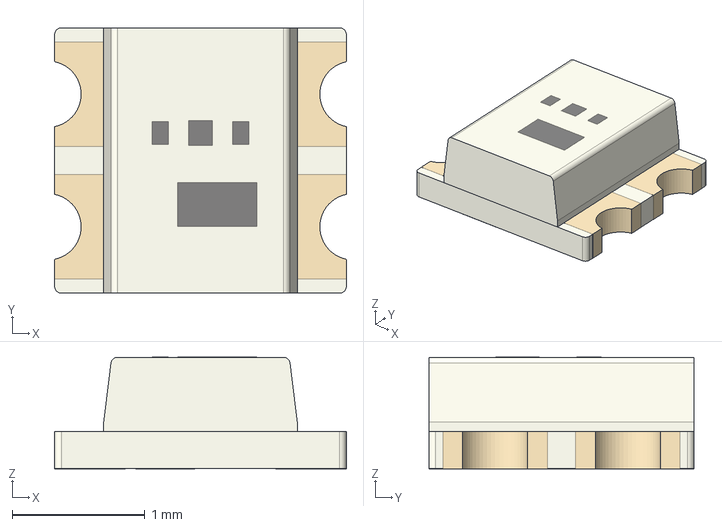
[picture p62: CAD file, 2024-07-13]
3dmodels/LED_WS2812_2020.step
2.20 x 2.00 x 0.842 mm
