ebastler/marbastlib/3dmodels/CON_HC-PBB40C-10DS-0.4V-4.0-02.step

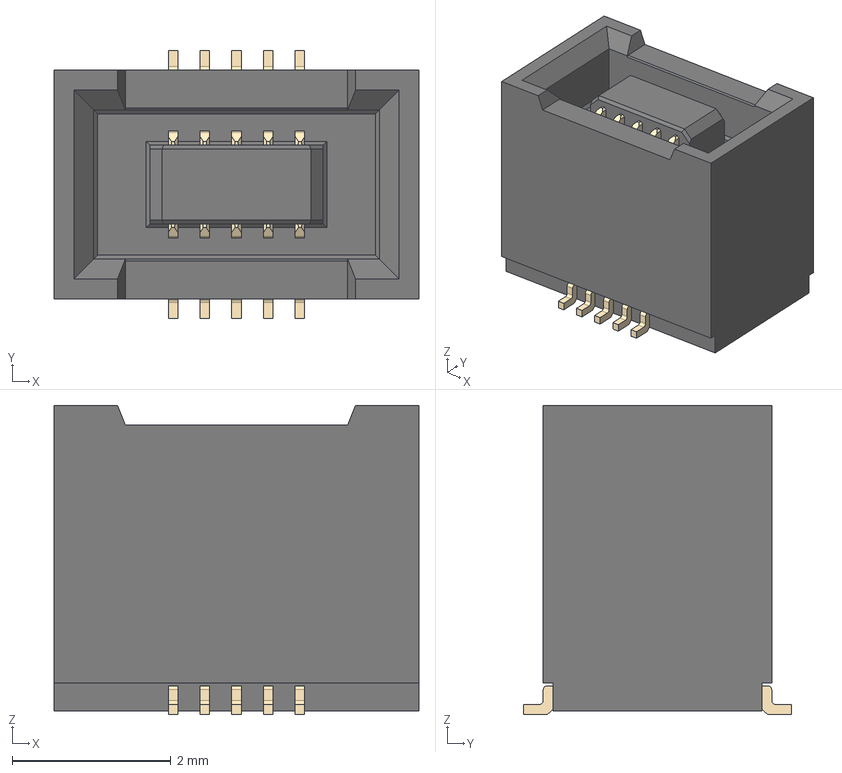
[picture p63: CAD file, 2024-07-13]
3dmodels/CON_HC-PBB40C-10DS-0.4V-4.0-02.step
4.60 x 3.38 x 3.90 mm
