ebastler/marbastlib/3dmodels/PNT_RKJXU1210006.step

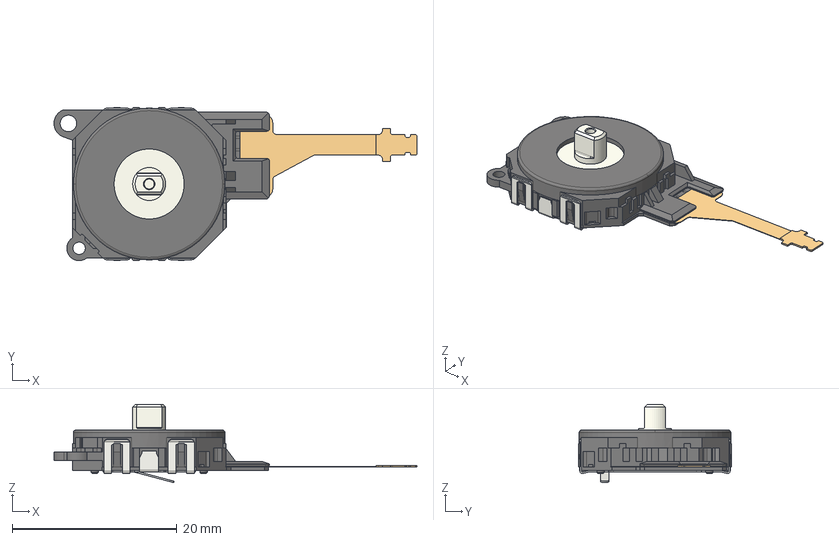
[picture p65: CAD file, 2024-07-13]
3dmodels/PNT_RKJXU1210006.step
44.0 x 18.6 x 9.50 mm
