ebastler/marbastlib/3dmodels/SW_SKHLLC.step

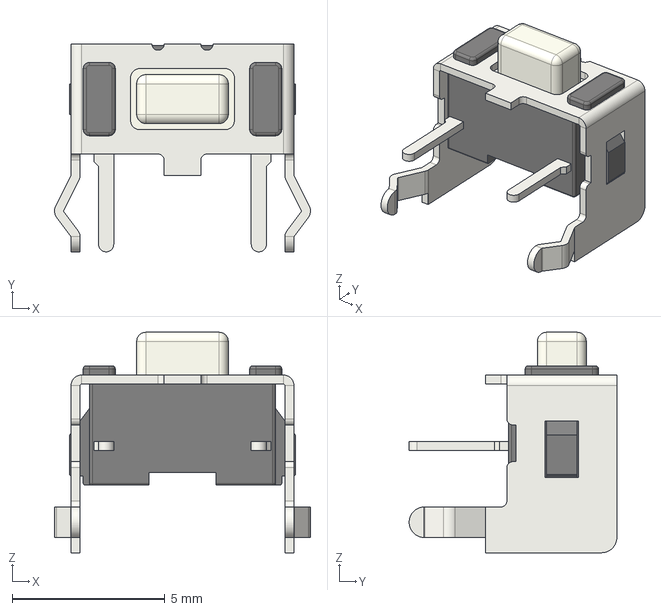
[picture p66: CAD file, 2024-07-13]
3dmodels/SW_SKHLLC.step
8.38 x 6.80 x 7.22 mm
