ebastler/marbastlib/3dmodels/LED_MHT151RGBCT.step

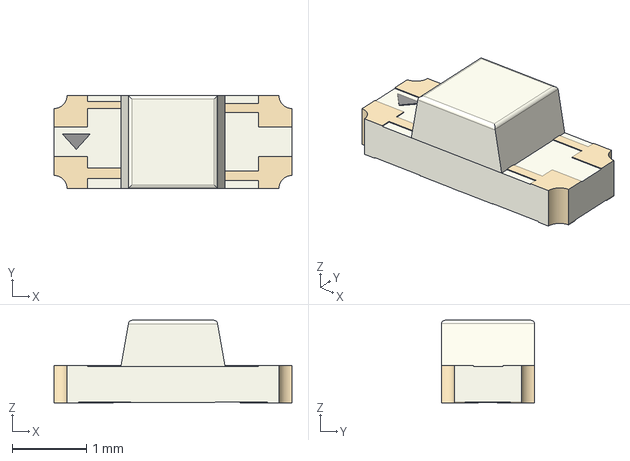
[picture p68: CAD file, 2024-07-13]
3dmodels/LED_MHT151RGBCT.step
3.20 x 1.25 x 1.11 mm
