ebastler/marbastlib/3dmodels/CON_781710005.step

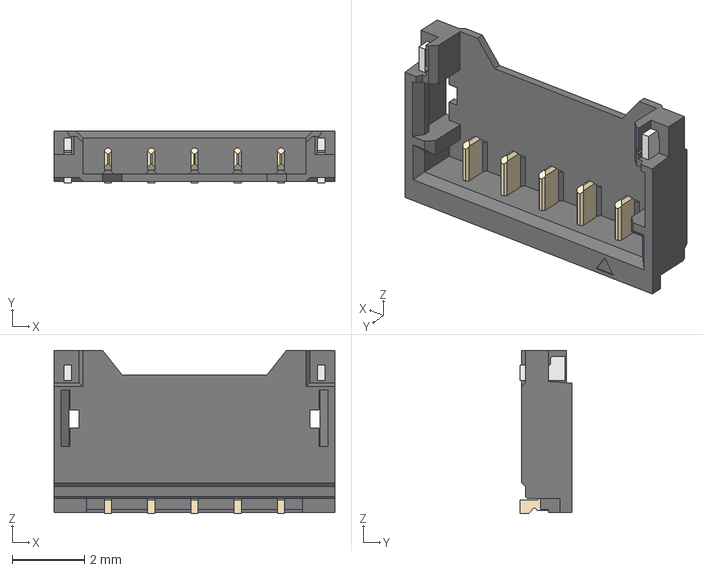
[picture p70: CAD file, 2024-07-13]
3dmodels/CON_781710005.step
7.80 x 1.45 x 4.53 mm
