ebastler/marbastlib/3dmodels/CON_2082940050.step

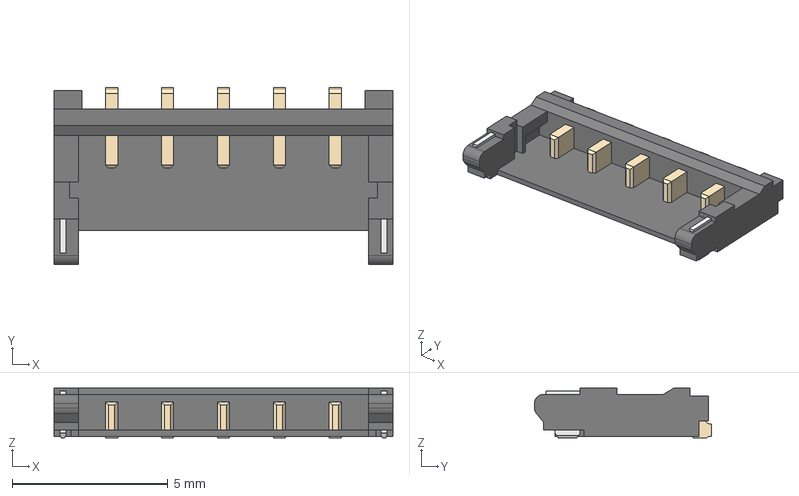
[picture p71: CAD file, 2024-07-13]
3dmodels/CON_2082940050.step
10.9 x 5.70 x 1.60 mm
