ebastler/marbastlib/3dmodels/SW_SSSS213100.step

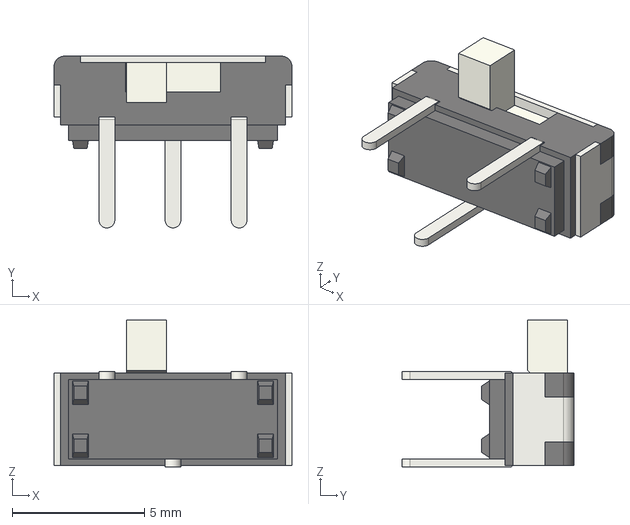
[picture p72: CAD file, 2024-07-13]
3dmodels/SW_SSSS213100.step
9.00 x 6.50 x 5.55 mm
