ebastler/marbastlib/3dmodels/CON_HytePro_M411P_Plug_1x04.step

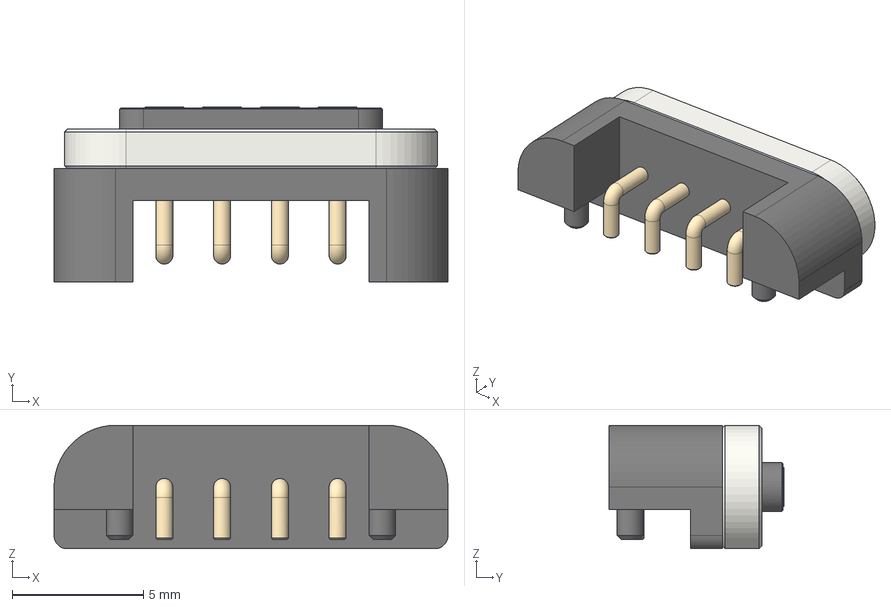
[picture p73: CAD file, 2024-07-13]
3dmodels/CON_HytePro_M411P_Plug_1x04.step
15.0 x 6.64 x 4.70 mm
Magnetic Connector Male - MiddlePart
Magnetic Connector Male - MountingPart
Magnetic Connector Male-tip_Standard
