ebastler/marbastlib/3dmodels/CON_SM02B-SRSS-TB.step

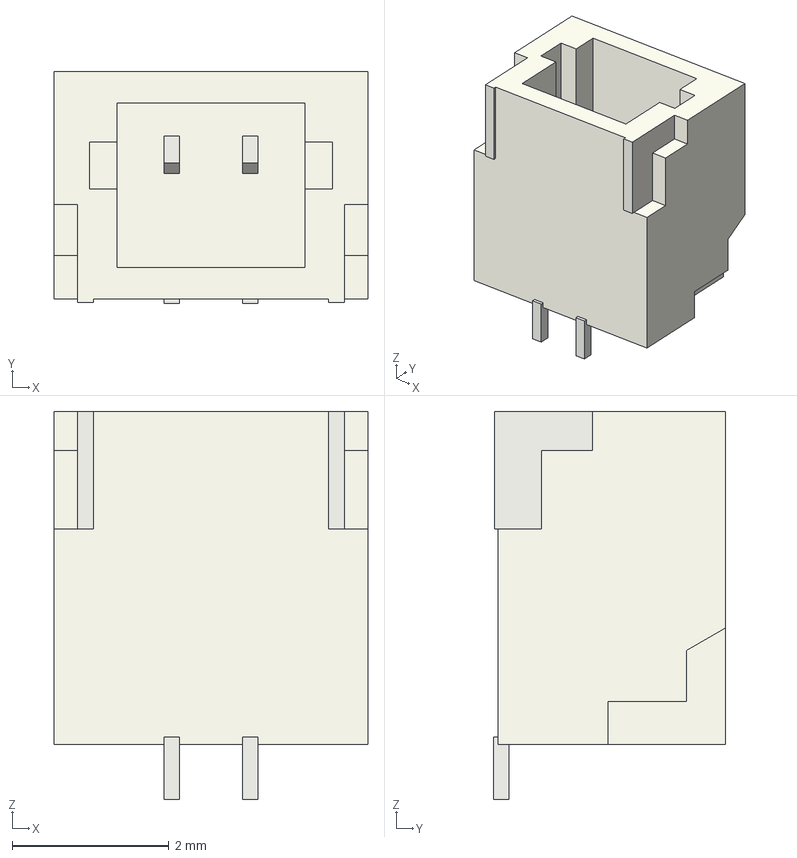
[picture p74: CAD file, 2024-07-13]
3dmodels/CON_SM02B-SRSS-TB.step
4.00 x 2.96 x 4.95 mm
