ebastler/marbastlib/3dmodels/CON_2082940020.step

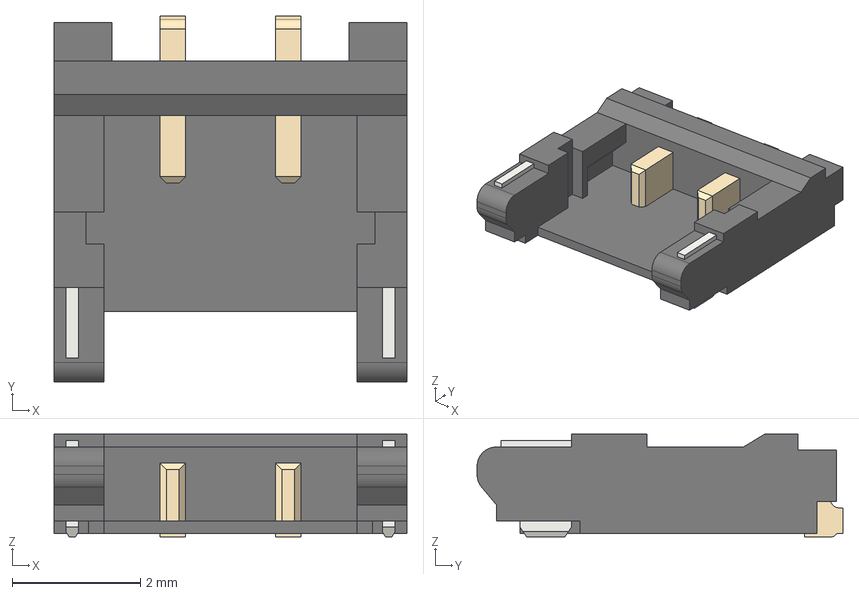
[picture p75: CAD file, 2024-07-13]
3dmodels/CON_2082940020.step
5.50 x 5.70 x 1.60 mm
