ebastler/marbastlib/3dmodels/CON_2121340005.step

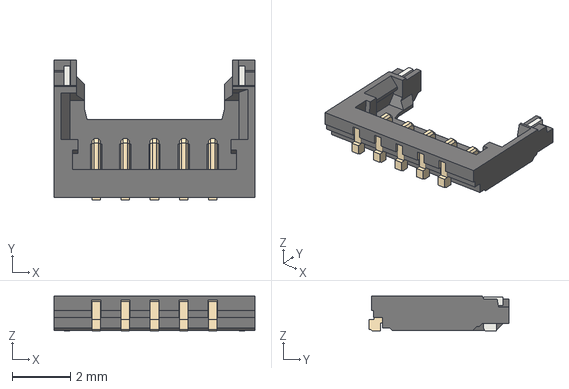
[picture p76: CAD file, 2024-07-13]
3dmodels/CON_2121340005.step
6.90 x 4.79 x 1.20 mm
