ebastler/marbastlib/3dmodels/CON_SM06B-SRSS-TB.step

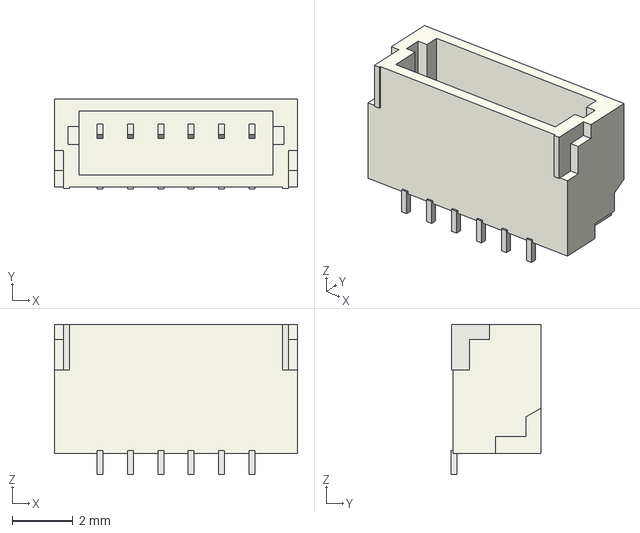
[picture p77: CAD file, 2024-07-13]
3dmodels/CON_SM06B-SRSS-TB.step
8.00 x 2.96 x 4.95 mm
