ebastler/marbastlib/3dmodels/CON_SM07B-SRSS-TB.step

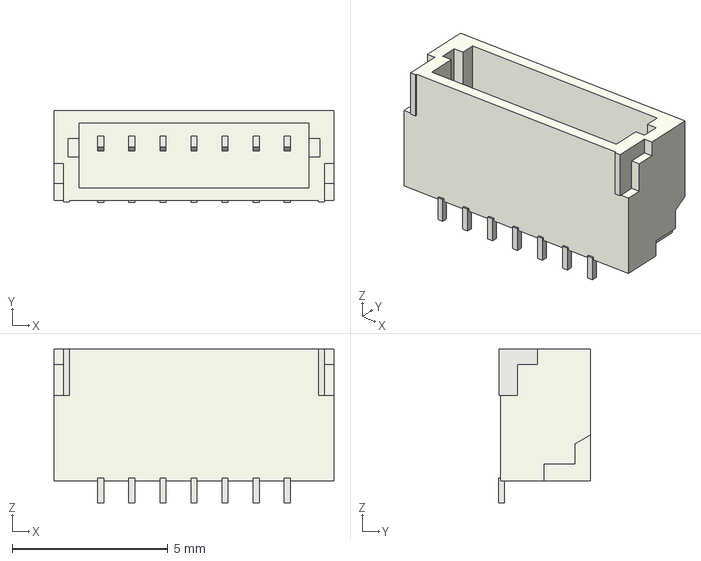
[picture p78: CAD file, 2024-07-13]
3dmodels/CON_SM07B-SRSS-TB.step
9.00 x 2.96 x 4.95 mm
