ebastler/marbastlib/3dmodels/CON_2121340003.step

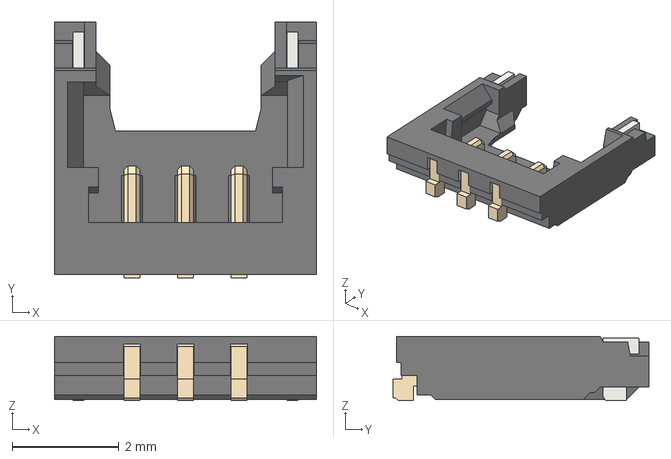
[picture p79: CAD file, 2024-07-13]
3dmodels/CON_2121340003.step
4.90 x 4.79 x 1.20 mm
