ebastler/marbastlib/3dmodels/QFN-13_3x4mm_P0.5mm.step

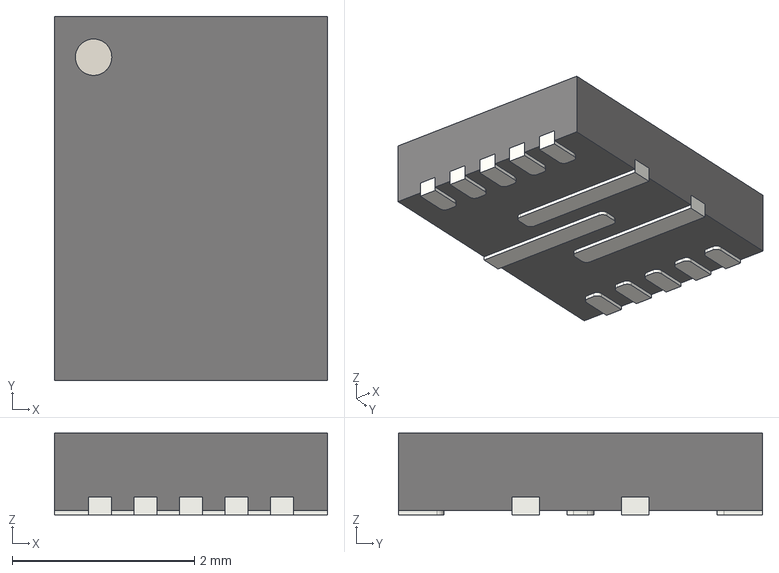
[picture p80: CAD file, 2024-07-13]
3dmodels/QFN-13_3x4mm_P0.5mm.step
3.00 x 4.00 x 0.9 mm
