ebastler/marbastlib/3dmodels/CON_781710003.step

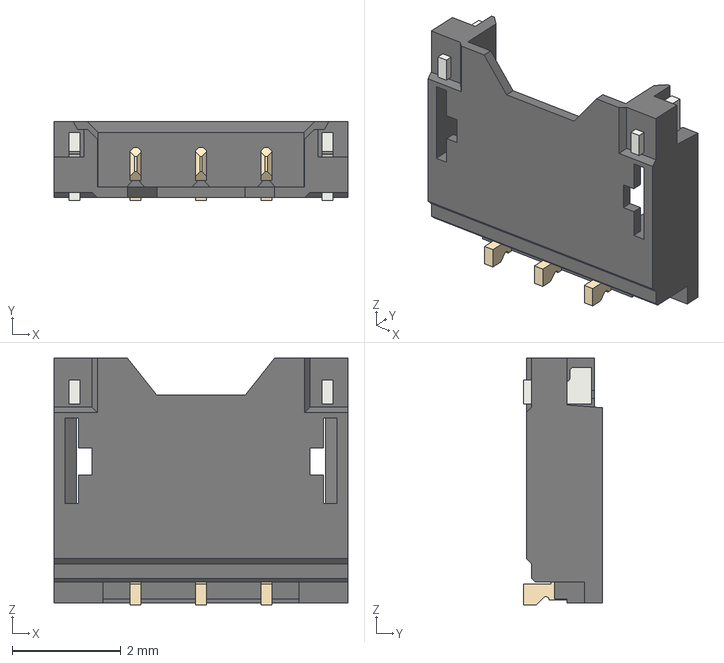
[picture p81: CAD file, 2024-07-13]
3dmodels/CON_781710003.step
5.40 x 1.45 x 4.53 mm
