ebastler/marbastlib/3dmodels/HS_KS-2P02B01-01_MX.step

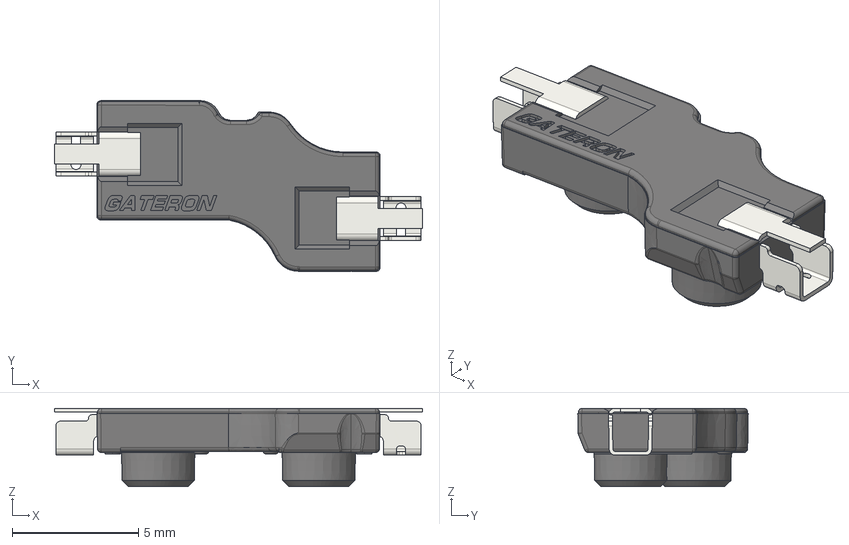
[picture p82: CAD file, 2024-07-13]
3dmodels/HS_KS-2P02B01-01_MX.step
14.6 x 6.74 x 3.10 mm
