ebastler/marbastlib/3dmodels/CON_781710002.step

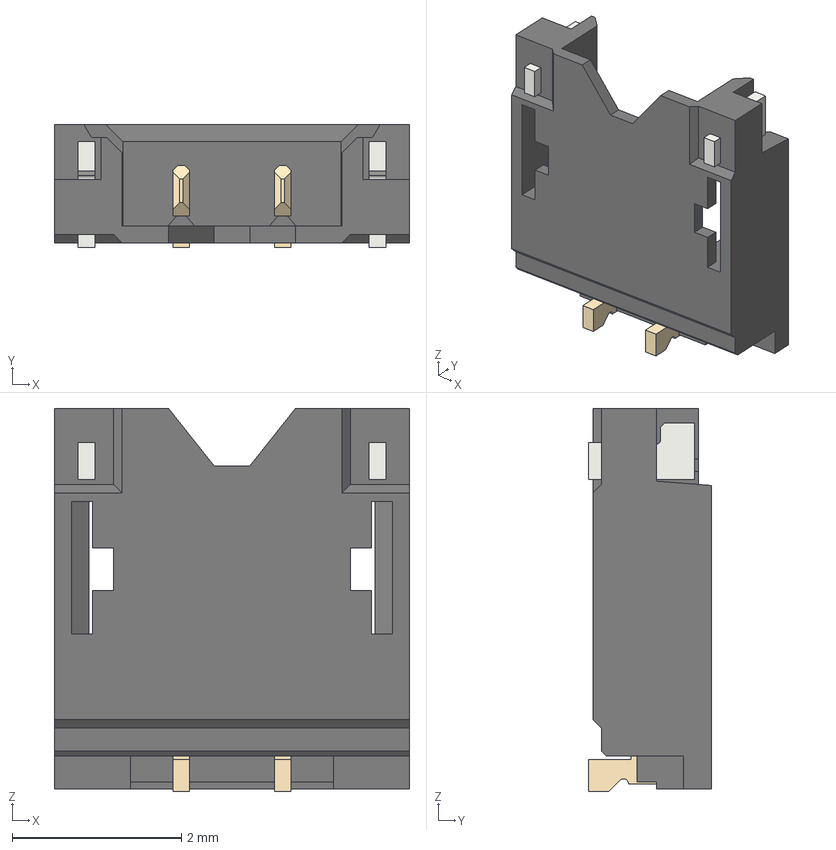
[picture p83: CAD file, 2024-07-13]
3dmodels/CON_781710002.step
4.20 x 1.45 x 4.53 mm
