ebastler/marbastlib/3dmodels/QFN-22_MP2722.step

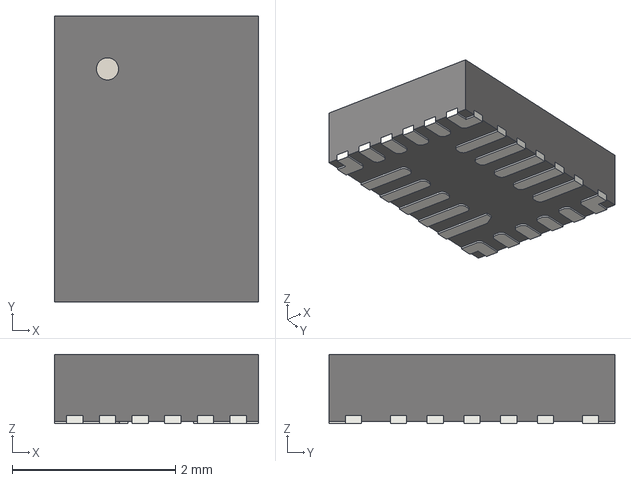
[picture p85: CAD file, 2024-07-13]
3dmodels/QFN-22_MP2722.step
2.50 x 3.50 x 0.85 mm
