ebastler/marbastlib/3dmodels/PNT_psp1000.step

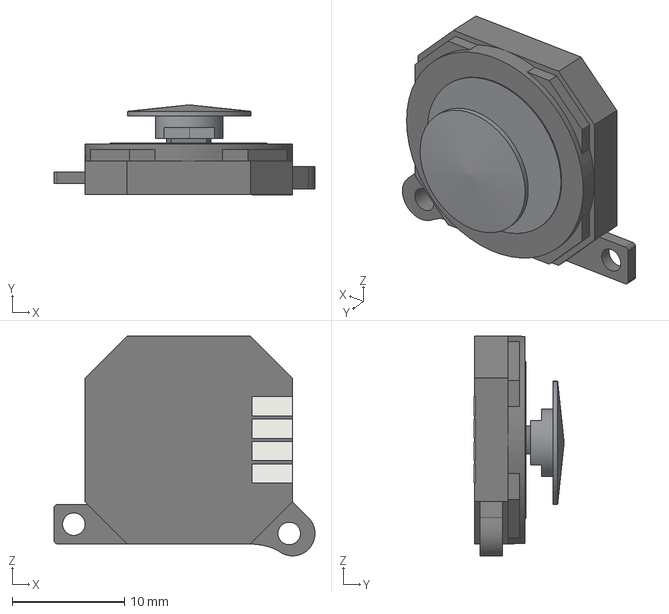
[picture p86: CAD file, 2024-07-13]
3dmodels/PNT_psp1000.step
23.2 x 8.05 x 19.6 mm
