ebastler/marbastlib/3dmodels/LED_WS2812_4020.step

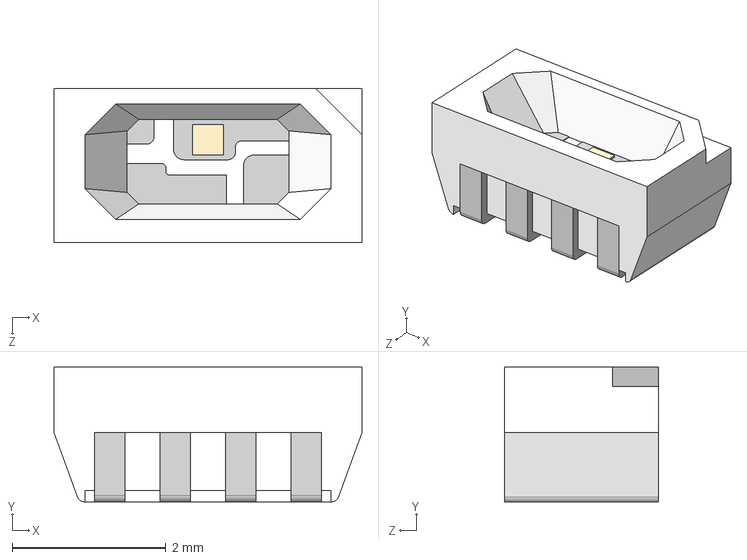
[picture p88: CAD file, 2024-04-17]
3dmodels/LED_WS2812_4020.step
4.00 x 1.75 x 2.00 mm
