ebastler/marbastlib/3dmodels/SW_MX6C-K3NB.step

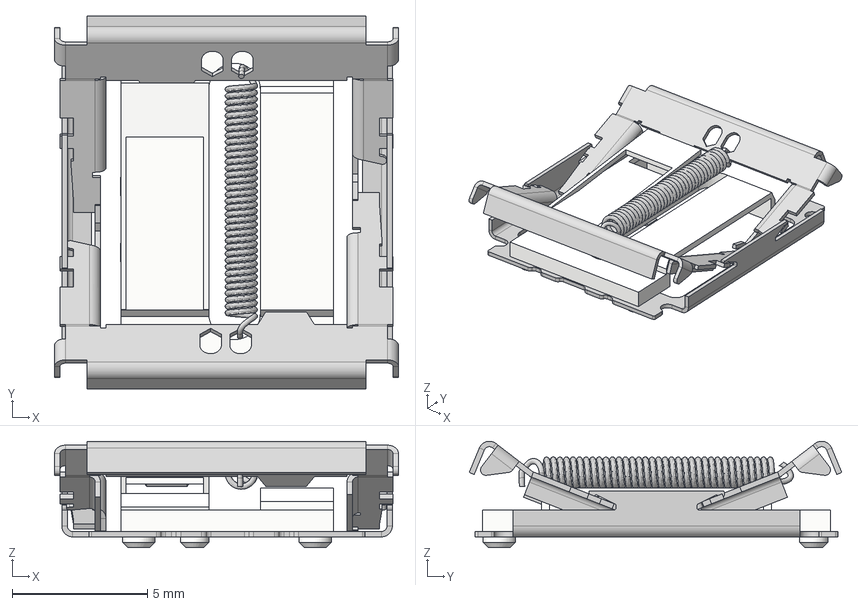
[picture p89: CAD file, 2024-02-21]
3dmodels/SW_MX6C-K3NB.step
12.7 x 13.8 x 3.93 mm
