ebastler/marbastlib/3dmodels/ROT_SKYLOONG_HS.step

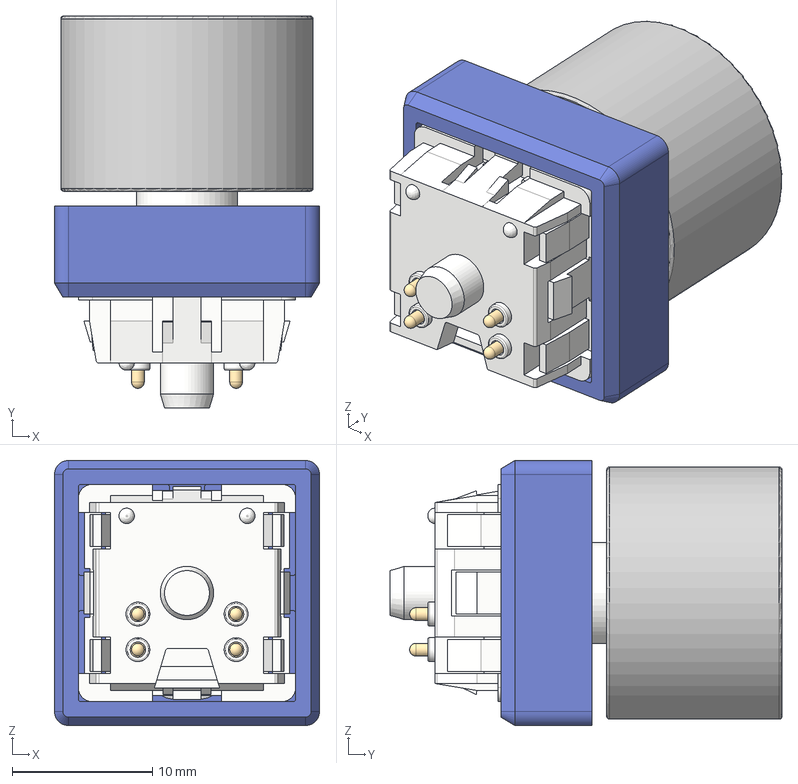
[picture p90: CAD file, 2023-05-17]
3dmodels/ROT_SKYLOONG_HS.step
18.9 x 27.9 x 18.9 mm
Top
Shaft
Pogo Pin x 4
Bottom
Top_1
Cover
Knob
