ebastler/marbastlib/3dmodels/SW_ESP3020.step

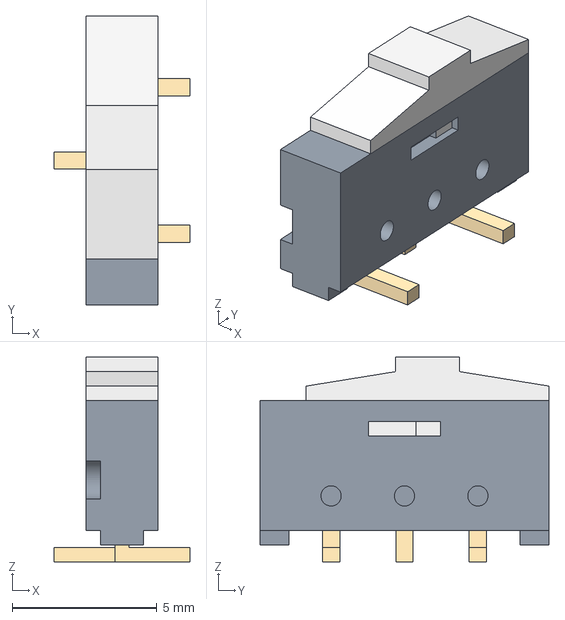
[picture p91: CAD file, 2023-04-03]
3dmodels/SW_ESP3020.step
4.70 x 10.0 x 7.08 mm
