ebastler/marbastlib/3dmodels/ROT_EC11N.step

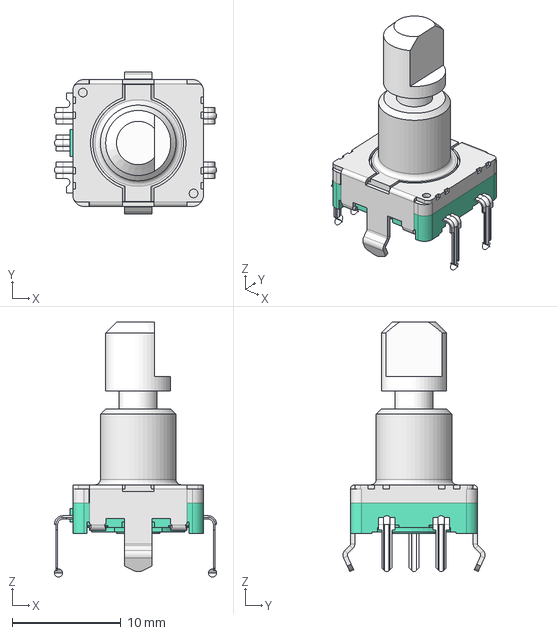
[picture p92: CAD file, 2023-04-03]
3dmodels/ROT_EC11N.step
14.9 x 13.1 x 23.5 mm
