ebastler/marbastlib/3dmodels/ROT_EC11E.step

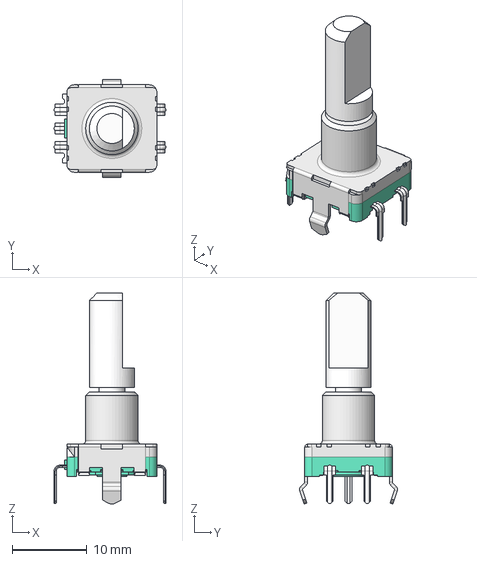
[picture p93: CAD file, 2023-04-03]
3dmodels/ROT_EC11E.step
14.9 x 13.1 x 28.2 mm
