ebastler/marbastlib/(list of files, cad)

Other CAD files:
3dmodels/Crystal_FA-128.step
