ebastler/marbastlib/(threads)

Thread 1 (2022-02-18):

Choc .kicad_sym file not present in Untested branch?

fatihG, 2022-02-18:
I tried to add the library files to KiCad after following the instructions on how to add the submodule.

After I did all the steps I was unable to locate the symbol library for the choc components.
The MX and Various .kicad_sym files are present and I am able to add those to KiCad.

Since I am planning on using chocs for my board, I figured using that library would be the easier option.

ebastler, 2022-02-19:
The only symbol I have in the mx.kicad_sym is a symbol for the stabilizers - I usually just use generic kicad pushbotton symbols for key switches, that's why the chocs don't have a dedicated symbol lib.

fatihG, 2022-02-20:
Makes sense.

I am very noob to all this PCB stuff, I forgot you had to manually assign footprints to symbols.

ebastler, 2022-03-04:
This has been addressed, together with some other issues, in today's patch. Thanks for pointing it out!
If you want to update to the latest lib:
`git submodule update --remote`, but watch out as it introduced some other changes as well (Mainly all hotswap and  reverse mount LED footprints are now flipped, and must manually be flipped back).

Closed 2022-03-04.

Thread 5 (2022-12-18):

Missing footprint for IS313741A

joelspadin, 2022-12-18:
The symbol for IS313741A uses footprint `marbastlib-various:QFN-60_EP_7x7_Pitch0.4mm`, but no such footprint exists.

ebastler, 2022-12-18:
That footprint hasn't been tested yet, hence it is only available on the `untested` branch.

I gave up having symbols split in tested and untested, since that is annoying to maintain with kicad sym libs. Symbols are all in all libs, footprints are separated into the branches.

joelspadin, 2022-12-18:
Ah, okay.

Closed 2022-12-18.

Thread 6 (2023-04-12):

Wrong preassigned footprints for Kailh Choc v1 symbols

ebastler, 2023-04-12:
Minor issue, will be fixed with the next regular update. Since choc footprints were renamed from `choc` to `choc-v1` when v2 were added, the symbols now point to non-existing footprints.

Closed 2023-04-18.

Thread 11 (2023-07-05):

Wrong pin number on promicroish/helios

ebastler, 2023-07-05:
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

Closed 2023-07-05.

Thread 13 (2023-07-06):

Wrong 3d model path for Molex_Pico-EZmate_PLUS_212134-0003_1x03-1MP_P1.00mm_Vertical

ebastler, 2023-07-06:
Molex_Pico-EZmate_PLUS_212134-0003_1x03-1MP_P1.00mm_Vertical has a wrong path, leading to 3d model not showing in pcbnew

Closed 2023-07-06.

Thread 15 (2023-07-06):

Pico EZmate family has wrong descriptions

ebastler, 2023-07-06:
Some descriptions are for wrong parts, they all still include "generated with kicad..." text as they were based on default libs footprints. Needs updating.

Also, EZmate Plus link to wrong datasheets.

Closed 2023-07-06.

Thread 16 (2023-07-31):

I'm running on 6.10 yet the symbol tells me to upgrade to a later version (V6 untested)

exorterna, 2023-07-31:
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
Kicad 6.10 was released at 12/20/22. How do I resolve this issue?

Thread 17 (2023-08-01):

Question about Choc stabilizer footprint

ubikitty, 2023-08-01:
The choc stabilizer footprint cuts two holes in the pcb.
I would like to know what they are used for and if they are mandatory?

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

ebastler, 2023-08-09:
Hi! The choc stabs themselves protrude through the PCB, so sadly they are mandatory. pretty annoying...

The big one is for the slider, can't remember what the small one is for. Probably the part holding the wire.

Ah, one caveat: The slider is offcenter for some weird reason, that makes Choc stabilized keys directional. Can only put them on "the right way", if you rotate the caps 180° they won't fit anymore. If you wanna use any sculpted profile caps (I do not know of any that exist), the stab orientation on the PCB/plate will determine which way the cap fits...

ubikitty, 2023-08-09:
Thank you very much for your answer and your insights on the quirks of the choc stabilizers! Did not notice that the stabilized keys were asymmetrical...

ebastler, 2023-08-09:
Found 2 pics of a MBK 2u cap, maybe they are interesting for this topic.

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

Closed 2023-08-09.

Thread 19 (2023-08-19):

SW_MX_HS_1u and mayber other hot swaps have an issue with kicad free rooting plugin

EcceGratum, 2023-08-19:
Hello,

I use the free rooting plugin in kicad and noticed that it tends to create tracks linked to the 2 holes of the hotswap (SW_MX_HS_1u, maybe others) which would not work.

I edited the footprint by changing the "Pad Type" of the 2 holes, i use "NPTH, Mechanical" instead of "Through-hole".
To get rid of the Clearance violation between the pads and the holes, i remove the small portion between the pads and the holes :

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

ebastler, 2023-08-20:
Hi! I think you're the first person to use the lib with autorouters, so we mainly focused around that usecase. The plated holes are used for stability, but also as a design element and for easier routing (as they can be used for traces which saves quite some manually placed vias).

I'm sorry it seems to affect your usecase, but the footprints were made the way they are for a reason, and changing them to NPTH would negatively affect other users (incl. us maintainers), so we will keep it the way it is.

Is it really a problem if the Autorouter connects to the PTHs? Since they are electrically connected to the pads, I am using them as contacts on a lot of boards as well.

EcceGratum, 2023-08-21:
Hello,
"Is it really a problem if the Autorouter connects to the PTHs? Since they are electrically connected to the pads, I am using them as contacts on a lot of boards as well."
Oh ok, may explain why the autorouter uses it, i though it would not work and looked a bit weird compared to other boards but if it works that's fine. This is the first board i am making so my knowledge is very limited.

I have no issue changing the footprints locally for my boards as it's quite easy and quick to do. I reported it thinking it could be an issue for other people.

If that's alright, i will close.

Closed 2023-08-23.

Thread 20 (2023-08-30):

MX_SW_solder & MX_SW_HS connector pin location difference

thoni56, 2023-08-30:
I tried to simply switch from MX_SW_solder to MX_SW_HS and was expecting to just do some minor adjustment of the wiring on the board. But it seems that the connector pins have "reversed" locations. Pin 1 is to the left in MX_SW_solder and to the right in MX_SW_HS.

I suggest making this the same would make changing from MX_SW_solder to MX_SW_HS much simpler.

ebastler, 2023-08-30:
Hi!

This slightly weird choice of mine is based on how KiCad handles component assembly. In a footprint, KiCad always expects the part to be assembled on the top side. MX switches for solder footprints are assembled from the top, so solder pads on B.Cu. Hotswap sockets however are assembled from bottom on a keyboard, so I had to put the solder pads on F.Cu and expect the user to flip all hotswap footprints to the "other side" of the PCB after placing them on the PCB.

This is a slight nuisance, but in return all assembly files will be generated correctly without manual tinkering on files. It will have solder switches as topside THT assembly and hotswap sockets as bottom side SMD assembly.

If you made a PCB for solder footprints, then changed them to HS footprints, you'll have to flip all of them to the other side once, easiest way: press `h` and click on F.Cu in the sidebar to highlight your interactions on the front copper layer, then hover the mouse over a socket, press `f`to flip, and repeat once for all other sockets.

Courtyards of the footprints are correct - 14x14mm on front (where the switch sits) and slightly larger than the socket on the back (where the socket sits).

Closed 2023-08-30.

Thread 21 (2023-09-08):

Too small PCB holes for Choc v1

bolleywall, 2023-09-08:
In marbastlib Choc v1 footprints, the diameter of the holes for the smaller mounting pins is 1.7 mm., while Kailh recommends 1.9 mm.

ebastler, 2023-09-08:
Hi! Thank you for pointing this out.

If I remember correctly we opted for this to allow plateless hotswap to work decently without wobbling, and then mistakingly used the footprint for both HS and solder.

It is tested and works (although the switches will afterwards probably sit loosely in 1.9mm hole PCBs if you remove them from ours). I am considering to keep it for hotswap, but switch to the recommended hole sizes for solder footprints as those do not need the mechanical stability of tight legs.

On the other hand I feel reluctant to change something tested and working. I will order a testing PCB with my next PCB order (with footprints with 1.7mm, 1.8mm and 1.9mm) and decide.

bolleywall, 2023-09-09:
Thank you for explaining your reasoning!  Now I too need to order a test PCB and compare various hole sizes for both the side posts and the middle one :-)

Apparently some feel 1.9 mm is too large (link for reference: https://old.reddit.com/r/ErgoMechKeyboards/comments/mdvy5w/what_size_through_holes_do_you_use_for_kailh_choc)

Thread 22 (2023-09-09):

Seeeduino Xiao boards support?

idesignstuff, 2023-09-09:
The Xiao (especially the NRF52840 "BLE" version) boards are an increasingly popular choice for split wireless ZMK keebs. Would you be willing to add them to your footprints/symbols library?
https://wiki.seeedstudio.com/XIAO_BLE/#resources

ebastler, 2023-09-09:
Hi!

I was planning to extend the promicorish lib and add (among others) xiao, but did not find the time for it so far - I mostly focused on footprints I needed myself recently as I was short on time.

Can't give any proper ETA, but it is planned :)

idesignstuff, 2023-09-09:
Thanks for considering it!

ebastler, 2023-09-11:
I'm currently beginning to work on them - if you have any recommendations on how to handle the bottom pads... This is a Xiao BLE, will also make a xiao rp2040 and maybe esp32 later on.

I know that on BLE you need the bottom pads for both flashing and battery. I will make a SMD only version (-> solder paste covered SMD pads, for reflow), but not quite sure how to handle them for THT and combo footprints...

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

Closed 2023-09-11.

Thread 23 (2023-09-09):

Wrong Pin numbers for MX_SK6812MINI-E Symbol

Bob837217, 2023-09-09:
According to the datasheet copy hosted at: https://datasheet.lcsc.com/lcsc/2305101623_OPSCO-Optoelectronics-SK6812MINI-E_C5149201.pdf
This was last edited on 2021-04-07 with revision "A/O"

Here is the pinout from that PDF:
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

Here is the Symbol pinout as seen in KiCAD 7.0.6:
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

```
PDF Pinout Numbers:
VDD:    1
DOUT:   2
GND:    3
DIN:    4

Symbol Pinout Numbers:
VDD:    1
DOUT:   2
DIN:    3
GND:    4
```

Symbol uses "VSS", but to my knowledge that means "GND".
So you can see that pins 3,4 are mismatched between the two.

ebastler, 2023-09-09:
Hi, this has been done for a reason - the footprint is shared between 2 LEDs with different pin numberings, so the symbol does not follow datasheet numbering, but footprint numbering.

If you compare the 6028 footprint, you will notice it deviates from the datasheet, but in the end the different numbering on symbol and footprint results in a correct pinout - these have been tested.

Bob837217, 2023-09-09:
Ok, thanks for the explanation.  I will mark this as closed.

Closed 2023-09-09.

Thread 24 (2023-10-31):

Inconsistent technical layers

ebastler, 2023-10-31:
F.Fab is missing drawings in most footprints, some lack values and/or references. Mainly affects switch footprints, but also some others (RGB LEDs, RF modules).

This should be cleaned up for everything that can/will be machine assembled.

Closed 2023-10-31.

Thread 28 (2024-02-14):

Gateron KS-27/33 support?

ZoeArch, 2024-02-14:
Gateron is offering low profile switches and their accompanying hotswap sockets, would it be possible to add these to this project?

https://www.gateron.co/products/gateron-low-profile-mechanical-switch-set

ebastler, 2024-02-14:
Hello Zoe,

I would love to, but I do not have access to datasheets, 3D models or similar for those. The switches themselves at least have tech drawings on the product site, but I have no idea about the sockets. I can try messaging Gateron, but I somewhat doubt they will get back to me...

I'll give the switches a shot, at least. Sockets and 3D models when/if I hear back from Gateron.

CosmicCuttlefish, 2024-02-19:
Hey ebastler,

I was looking at gateron's website and found these 3D models: https://www.gateron.com/pages/products
And product specifications: https://www.gateron.com/pages/product-specification
Not sure if this helps but I thought I'd bring it up

ebastler, 2024-02-19:
Huh, how did I miss that! Thanks. Gateron themselves sent me the info via email by now, but that's great to know if I will ever need it again!

CosmicCuttlefish, 2024-02-19:
I'm glad they sent over the info! Do you have an ETA for these footprints? No pressure, just curiosity.

ebastler, 2024-02-19:
Hmm, depends on my spare time, motivation and if I want to push switch/stab 3D models along with it. I think I will do footprints alone for now, and add switch/stab models in a later, larger lib update.

ebastler, 2024-02-20:
Okay, I was motivated... :D

The files are up, but I will not create a new release until I have time to immediately debug and hotfix. This commit changes a ton of things to account for the fact that now there is 2 different MX-style HS sockets, so I remade the entire HS socket file/footprint names etc.

ebastler, 2024-02-20:
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

IIIBlueberry, 2024-07-01:
Need help KitCad 8.0.3 cannot load KS-2P02B01-01 footprint?

`Processing symbol 'MX1:PCM_marbastlib-mx:SW_MX_HS_CPG151101S11_1u'.
Processing symbol 'MX2:PCM_marbastlib-mx:SW_MX_HS_KS-2P02B01-01_1u'.
Add MX1 (footprint 'PCM_marbastlib-mx:SW_MX_HS_CPG151101S11_1u').
Error: Cannot add MX2 (footprint 'PCM_marbastlib-mx:SW_MX_HS_KS-2P02B01-01_1u' not found).
Total warnings: 0, errors: 1.`

Finnitio, 2025-01-02:
Is there a reason for making the hole for the plastic cylinder of the switch 5,25 mm?

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

The max, size in the drawing is 5,05 mm. I could not find any explicit size for the pcb hole.

Closed 2024-02-20.

Thread 29 (2024-02-19):

Dead link for LED_6028R

ZoeArch, 2024-02-19:
The link https://www.alibaba.com/product-detail/SMD-6028-Smd-Led-RGB-color_60283039151.html leads to a "product no longer available" page
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

ebastler, 2024-02-19:
Hmm. I think I used this supplier before: https://www.alibaba.com/product-detail/high-brightness-reverse-mount-4-pin_60782094930.html

Updated the readme accordingly.

Closed 2024-02-19.

Thread 30 (2024-02-25):

Could use an update to point to 3D Model files in KiCAD 8.

machineabuse, 2024-02-25:
As above, despite being able to install the libraries within KiCAD 8's PCM, the 3D model locations are still directed to KiCAD 7, requiring manual linking.

One other peculiarity is that within KiCAD 8, the MX Hotswap footprint and model names have an added code string, not sure if this affects only the MX Hotswap footprints or other files as well.

ebastler, 2024-02-29:
Thanks for reporting this!

Will tackle that once I find the time to migrate to kicad 8 myself. I have some larger projects on kc7 and no time to deal with migration. As long as I am on kicad 7 on my work machine, I can not yet switch the lib over. Hope I will get to it this weekend.

machineabuse, 2024-03-01:
You're an absolute sir! ❤

Closed 2024-03-01.

Thread 31 (2024-03-19):

DRC fail on SK6812MINI-E footprint ("Error: Board edge clearance violation (boa...clearance 0.3500 mm; actual 0.2531")

todbot, 2024-03-19:
I'm trying to place the SK6812MINI-E footprints and DRC is giving me a board clearance error for the pads. (see screenshot)
Is there a way to fix this without reducing the global board clearance or is that what everyone does (I'm fairly new to Kicad, coming from Eagle)

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

ebastler, 2024-03-30:
Hi! That error is no problem - you can either get rid of it by lowering edgecut to pad clearance in your board setup,or just ignore it.

I will try to adjust the pads a little when I find time, so it will no longer throw errors in the first place!

todbot, 2024-03-30:
Hi, thanks for responding. I've since found DRU settings for the fabs I'm using and these errors do go away. (Looks like KiCad's defaults are pretty conservative).  Thanks for your patience in me being a newb with KiCad. It's very nice and your library with these complex parts has made the transition much easier. Closing this issue.

Closed 2024-03-30.

Thread 33 (2024-06-14):

SK6812 mini-e wrong pinout

Trecoolius, 2024-06-14:
Pins 3 and 4 are swapped, I just lost $100 to this.

ebastler, 2024-06-14:
Hi,

Sorry for your issues. Which symbol did you use? The ones included in this library account for the swapped pins and works.

This originates in the fact that the footprint was originally made for a different passive RGB LED, and then re-used for MINI-E but kept the pin numbering of the old LED. I have used 3 LEDs with different pin numbers with the same footprint by now, symbols taking care of the pinouts.

As long as you used one of the MINI-E symbols from marbastlib, the wrong pin order is not your issue. This combination has been prototyped and used for production on countless boards.

Closed 2024-06-19.

Thread 35 (2024-07-11):

LED_MX_6028R-ROT footprint seem not fit with switch

Halogene116, 2024-07-11:
Dear Mr. marbastlib
LED_MX_6028R-ROT in MX footprint seem bigger than switch (1u), so I have to use Led 6028 form Choc library.
Beside that, MX stab library seem not fit to switch too. I just use the Kicad for fisrt time so sr if it not true.
And I need a bigger Mec Keyboard than 104 Fullsize, so i need a PCF8575 I/O Expander module for more pins to control many switch and LED. I have searched for symbol and footprint but no hope to get right. Would you mind to make a symbol and footprint for PCF8575 module as picture?

Thank you so much for your library. It helps me so much for make my own keyboard.
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

ebastler, 2024-07-11:
Hello!

I try to address all points - hope I am not missing any.

1) Both footprints are `19.05` by `19.05` mm on the user.drawings layer, as they should be (usual spacing between MX switches is `19.05` by `19.05`):
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

I am not quite sure what you mean with the LEDs being larger.

2) The same applies to stabilizers - `19.05` by `x * 19-05` as well, with x being the length of the stabilizers in "units". It all lines up as it is supposed to. Don't let my colors confuse you, I am not using the default KiCad color scheme, so things may look a little different.
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

3) Which microcontroller are you using? In general I would rather recommend using a larger controller (like STM32F072RBT6 which I used on E80-1800), those should be able to work with plenty of keys to go way beyond 104 key fullsize. IO expanders lead to increased input delay and hugely increased firmware complexity.

If you still want to use an IO expander, I would rather put the bare chip directly on the PCB. This expander breakout board has barely any components on it, and I honestly have no idea what the voltage regulator and the two transistors are even doing - there is no trace of those in the chip datasheet. Maybe some level shifting circuit for which I see no reason to exist. I have used PCA9555 IO expanders with QMK keyboards before, put the chip directly on the PCB.

If you have detailed measurements for this expander breakout PCB (pin spacing) I can still make a footprint and push it sometime in the next couple of days.

Good luck and enjoy the process of designing your first keyboard! Don't be overwhelmed by the amount of new information early on, it gets easier with time!

Kind regards,
Moritz

Halogene116, 2024-07-12:
Dear Mr. Marbastlib,
Thank you for your info about input delay things. And I need some more advice about my Mec Keyboard.
1. My Keyboard has 30 cols and 6 rows, so total it needs 36 pins for keyboard matrix.
My old plan is use 1 Arduino Micro Pro (Atmega32U4 chip) and some IO expansion module through I2C protocol to control the matrix. But as you said it will delay the input things. So I need an advice to improve it like:
a. Use a module control with over 36 pins. (quite expensive to me, )))
b. Use 2 Arduino Micro Pro modules (or more) as master and slaves model to have enough pins (cheaper than "a" solution) but I don't know if it has input delay things like my old plan.

2. My Keyboard also has RBG leds. I also want to control every single Led as Switch, so I plan to get more Pins to Led matrix as Switch Matrix. So how can I design my control module to get it? And the Leds is not important as Switch so I can accept it delay a little bit than Switchs.

I look forward to hearing more advice from you.
Thank you so much.

ebastler, 2024-07-12:
1) For this many switches I would use a stm32f072rbt chip directly, instead of an Arduino/module. jlcpcb can solder those for cheap for prototypes, and you only need ~5 capacitors and 2 resistors together with the chip, I think. Can not remember exactly. A bit more difficult than using an Arduino, but not a huge problem.
2) Use either SK6812MINI-E (WS2812 protocol, but reverse mounted for keyboard per key RGB) or use one (or more) dedicated LED controllers like ISSI IS31FL3733. The SK6812MINI-E are way easier to wire. The ISSI is more cost efficient for larger PCB production batches. But for small batch sizes and as a beginner, I would recommend SK6812. Marbastlib has the `MX_SK6812MINI-E` symbol with footprint already assigned. Tested and working. So you only need 1 pin on the MCU for all your LEDs.

Halogene116, 2024-07-15:
Dear Mr. Marbastlib,
Thank you for your info. I will apply it to my Keyboard.
And if i don't have stm32f072rbt chip, can i use stm32f104xxx or higher different stm chip.
Thank you so much.

ebastler, 2024-07-22:
You can in theory use any chip from this list (assuming you want to run QMK firmware on your board): https://docs.qmk.fm/compatible_microcontrollers

I just recommended the F072 series since they are the easiest to use - no need for dedicated programming tools, no crystals. Just the microcontroller and a handful of capacitors and resistors.

Something like this works well for smaller amounts of LEDs. Alternate `PCM_marbastlib-mx:LED_MX_6028R` and `PCM_marbastlib-mx:LED_MX_6028R-ROT` between rows so the datalines can "snake" left and right alternatingly.

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

If you have more LEDs (and you do), take care of using sufficiently thick power traces, and lay them down in a better way. The Way I did it here with the power traces snaking left and right too would lead to way too long tracks, which need to be very thick.

Something like this might be better suited for your application - pick one spot on the board where you can comfortably put down a thick vertical connection between the power pins of all LED rows.

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

Halogene116, 2024-07-26:
Thank you so much for everythings. It really helpful for newbee like me.

Closed 2024-07-26.

Thread 36 (2024-10-12):

DIODE

Finnitio, 2024-10-12:
Hey,

I was wondering if adding a standard diode would be helpful? Just spent some time to research which to use and find the correct ones for ergo mech keyboards. I suppose the smd handsolder ones are 1N4148W aswell? Couldn't relly find a footprint and now I need to get to bed ;). Thanks for the library.

ebastler, 2024-10-20:
Hi! We only add footprints and/or symbols to this lib that either do not exist in KiCad default libs already, or which we believe we can improve in any significant way over the deafault ones. SOD-123, SOD-323 and SOD-523 footprints from the base libs are, in my opinion, perfect as they are, so not planned to include them to the lib.

Regarding your issues - `1N4148W` do not have any dedicated footprint in KiCad libs, as they use a common SOD-123 footprint, shared with many other diodes. That one is part of KC base libs. You can find `1N4148W` in the KiCad symbols library, and it will automatically assign the correct footprint to the symbol from the base libs.

Closed 2024-10-20.

Thread 38 (2025-01-27):

KS27 KS33 Hotswap footprint hole too big.

Finnitio, 2025-01-27:
I just received pcbs and the hole diameter is too big with 5.25 mm. The switches are completely lose and only stay loose in place due to the hotswaps.

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

ebastler, 2025-02-16:
Thanks for reporting this! Only got to check it out now...

The footprints are following Gaterons recommended landing pattern, which is quite confusing. I wonder how wide I should make the hole.

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

Kailh Choc have a 3.2mm center pole and the recommended footprint states 3.4mm, so 0.2mm "clearance" just like Gateron did here. That seems to work fine on Kailh. I wonder why it does not on Gateron.

Did you measure the actual hole with calipers to make sure the factory did not make a mistake and used the wrong drill bit?

Finnitio, 2025-02-18:
I did not measure them, but considering the other drawing it is obvios that there is some play in the contact pair.
