ebastler/marbastlib/(commit log)

2023-04-03 marbastlib v7 launch
    [CON_BM02B-ACHSS.step, CON_HytePro_M411P_Plug_1x04.step, CON_HytePro_M411P_Receptacle_1x04.step, CON_MJ-4PP-9.step, CON_SM02B-SRSS-TB.step, CON_SM04B-SRSS-TB.step, CON_SM05B-SRSS-TB.step, CON_SM06B-SRSS-TB.step]
2023-04-18 Addressed issue #6, added MX plate footprints
2023-04-21 moved revmount led references to better spot
2023-05-16 Added SKYLOONG knob module footprint and symbol.
2023-05-17 added Skyloon hotswap encoder from #7 with some slight rework
    [ROT_SKYLOONG_HS.step]
2023-05-21 Adjusted readme to make copying of KiCAD repo link easier.
2023-05-30 added promicroish controllers
    [Liatris.step]
2023-07-03 Added footprint for WS2812B-4020
2023-07-05 moved 2040 led to experimental lib for now, removed 2020 3d model from files
2023-07-05 addresses #11, wrong pin numer on helios
2023-07-06 add molex ezmate footprint/3dmodels
    [CON_2121340002.step, CON_2121340003.step, CON_2121340004.step, CON_2121340005.step, CON_2121340006.step, CON_781710002.step, CON_781710003.step, CON_781710004.step]
2023-07-06 imroved readme, removed legacy changelog, added missing footprint entries
2023-08-09 add copy of KiCad HRO M12 footprint, but with added 3d model
2023-08-09 updated to mention new HRO M-12 footprint
2023-08-30 fixed 0.01mm offset of ezmate 3pin pads
2023-09-11 Added seeeduino xiao symbols, footprints, 3d model as proposed in #22
    [seeeduino_xiao_rp2040.step]
2023-09-11 fixed 3d model path for liatris controller footprints
2023-09-12 simplified xiao rp2040 model
    [seeeduino_xiao_rp2040.step]
2023-09-12 fixed silkscreen labels and moved origin of Xiao footprints
2023-09-24 Improved HytePro M411P footprints and added ones that make the connector sit flush with PCB edge
2023-10-31 add hytepro footprints that should sit flush with the PCB edge
2023-12-28 symbol + footprint: nRF52840 E73-2G4M08S1C
    Adds symbol and footprint for nRF52840 module,
    E73-2G4M08S1C that has great availability on
    JLC/LCSC.
2024-01-01 added ebyte E72 .step, cleanup of moko and holyiot modules
    [ebyte_E73-2G4M08S1C.step]
2024-01-01 add Diptronics T1A2QR
    [SW_T1A2QR.step]
2024-02-18 move 1206R LEDs from experimental to stable
2024-02-18 move flush-mounted-hytepro from experimental to stable
2024-02-18 fix symbols where footprint paths still point to xp lib paths
2024-02-19 add gateron KS-2P02B01-01 hotswap sockets, adapt existing hotswap footprint and 3d model naming schemes to adapt
    [HS_CPG135001S30_Choc.step, HS_CPG151101S11_MX.step, HS_KS-2P02B01-01_MX.step]
2024-02-19 add Gateron KS-33 footprints as requested in #28
    [HS_KS-2P02B01-02_KS33.step]
2024-02-20 fix silkscreen clipping into switch hole on MX style gateron hotswap
2024-02-21 update MX ULP footprints
    adds a 3d model to the ULP footprints aswell as a forgotten courtyard
    [SW_MX6C-K3NB.step]
2024-02-29 add molex pico ezmate HC series
2024-02-29 rename gateron lp symbols/lib to be in line with footprint lib name
2024-02-29 add ezmate HC step files
    [CON_2082940020.step, CON_2082940030.step, CON_2082940040.step, CON_2082940050.step]
2024-03-14 improve footprint for XUNPU_FPC-05F-16PH20
    [CON_XUNPU_FPC-05F-16PH20.step]
2024-03-30 move marbastlib from KiCAD 7.0 to KiCAD 8.0
2024-03-30 attempt to pass target kicad version to repository generating script
2024-03-31 update marbastlib to work with multiple projects in ebastler-kicad-repository
2024-04-17 updated polarity marks to kicad 8 library style
2024-04-17 moved pico ezmate HC from xp to stable library
2024-04-17 improve WS2812 4020 footprint and add 3d model
    [LED_WS2812_4020.step]
2024-04-17 add MP2722
    [QFN-22_MP2722.step]
2024-04-27 promicroish: add SuperMini nRF52840
    I created a board w/ the nice!nano footprint but, after
    receiving the board, noticed that the footprint was
    slightly different than expected.
    Using the exported footprint from the wiki page, I
    created the same set of footprints the nice!nano has
    and a symbol (exactly the same as the nice!nano)
    I also changed two of the pin names for the nice!nano symbol
    as they had a "-" instead of a "." in the "Px.xx" pin name.
2024-07-09 add new/refactor existing xunpu ffc connectors
    [CON_XUNPU_FPC-0.5AL-20PB.step, CON_XUNPU_FPC-05F-20PH20.step, CON_XUNPU_FPC-05F-24PH20.step]
2024-07-09 fix issue with MP2722 footprint
2024-07-09 add HRO M-23, update 3d models for M-12 and M-14 to match
    [CON_TYPE-C-31-M-12.step, CON_TYPE-C-31-M-14.step, CON_TYPE-C-31-M-23.step]
2024-07-09 add various power inductors
    [L_Bourns_SRP6050CA.step, L_Bourns_SRP6060FA.step, L_Cenker_CKST353220.step]
2024-07-09 add MP3431
    [QFN-13_3x4mm_P0.5mm.step]
2024-07-09 fix footprint path for MP2722
2024-07-09 add a bunch of power MOSFETs
    [CON_HC-PBB40C-10DP-0.4V-02.step, CON_HC-PBB40C-10DS-0.4V-2.0-02.step, PDFN3.3x3.3.step, U-DFN2020-6.step]
2024-07-09 correctly add mezzanine style connectors which I accidentally added in a previous commig
2024-07-10 replace incorrectly colored MP2722 3d model
    [QFN-22_MP2722.step]
2024-07-13 rework 3d models to follow kicad model colors
    [CON_2082940020.step, CON_2082940030.step, CON_2082940040.step, CON_2082940050.step, CON_2121340002.step, CON_2121340003.step, CON_2121340004.step, CON_2121340005.step]
2024-08-18 Fix description of Xiao footprints
2024-08-18 add Waveshare RP2040-Matrix controller
    [RP2040-Matrix.step]
2024-09-27 add Kailh PG1316S Switch footprint
2025-02-16 add Gateron Magnetic Jade and compatible footprints/symbols, move XUNPU_FPC-0.5AL-20PB to tested category
2025-06-14 move gateron HEs from XP to stable, reduce pin diameter from 1.7mm (datasheet value) to 1.6mm (better value according to my test PCB)
2025-06-14 fix path to gateron HE switch footprint
2025-06-28 fix: fix pin types on E73 module
2025-08-03 slight updates to ezmate footprints to avoid DRC errors
    [libmanagement.kicad_sch]
2025-08-03 Correct various footprint issues
2025-08-03 set pad property of HS socket through holes to mechanical to avoid DRC errors
2026-03-22 Huge release for KiCad 10.0, many new parts
    [ANT_Johanson_2450AT18D0100001E v1.step, Crystal_SMD_2012-2Pin_2.0x1.2mm.step, Crystal_SMD_2016-4Pin_2.0x1.6mm.step, Diodes_UDFN1212-3_Type-C.step, LED_Everlight_15-13DR6GHBHC-A012T.step, Mounting_Sinhoo_SolderElement_SMTSO3035CTJ.step, Mounting_Wuerth_WA-SMSI-M2.5_H1mm_9774010151R.step, Mounting_Wuerth_WA-SMSI-M2_H3P5mm_9774035243R.step]
